LimeProgramming/USB-2-232-KBD/README.md

# USB-2-232-KBD
 Converts USB mice and USB keyboards to serial mice and XT-AT-PS/2 keyboards.
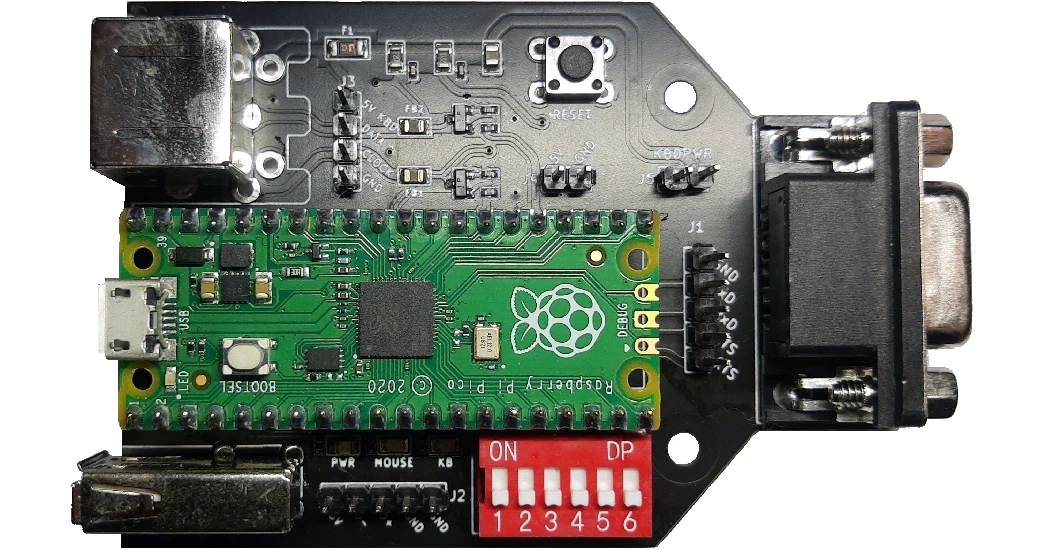
[picture p1: images/built.webp]
ASSEMBLED_ADAPTER
  

# Development
In progress, not ready for production

## About
This project is an extension of a previous project that you can find here  [previous project that you can find here.](https://github.com/LimeProgramming/USB-serial-mouse-adapter)
My previous project just converted USB mice to Serial mice, this project aims to also convert USB keyboards to XT-AT-PS/2 keyboards. 

# Features
### KVM:
Support for use on KVMs has been added as of version 1.1.1. 
It works fine on my **one**, startech branded, KVM that I have test with. Given that TinyUSB is a bit picky, your results may vary.

## Mouse Features
With this adapter you can convert a modern native USB mouse to a classic serial mouse. 
Want to use an optical mouse on a 386 running Wolfenstein 3D? Well now you can! Want to use a wireless optical mouse on a 486 running Doom? Well you might be able to! (depending on the mouse)

**Supported Protocols:**
- Microsoft Two Button
- Logitech Three Button
- Microsoft Wheel

## Hardware
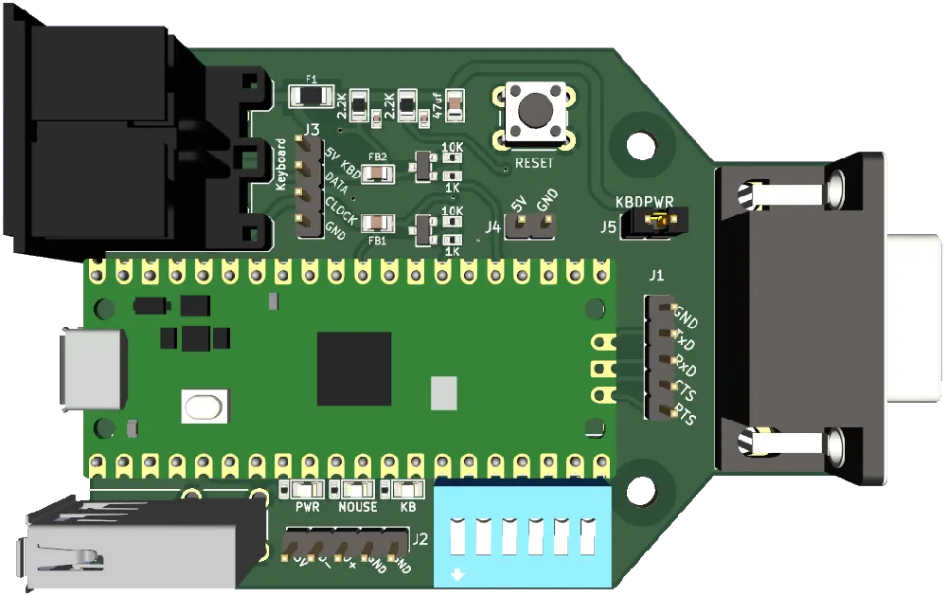
[picture p2: images/front_nobg.webp]
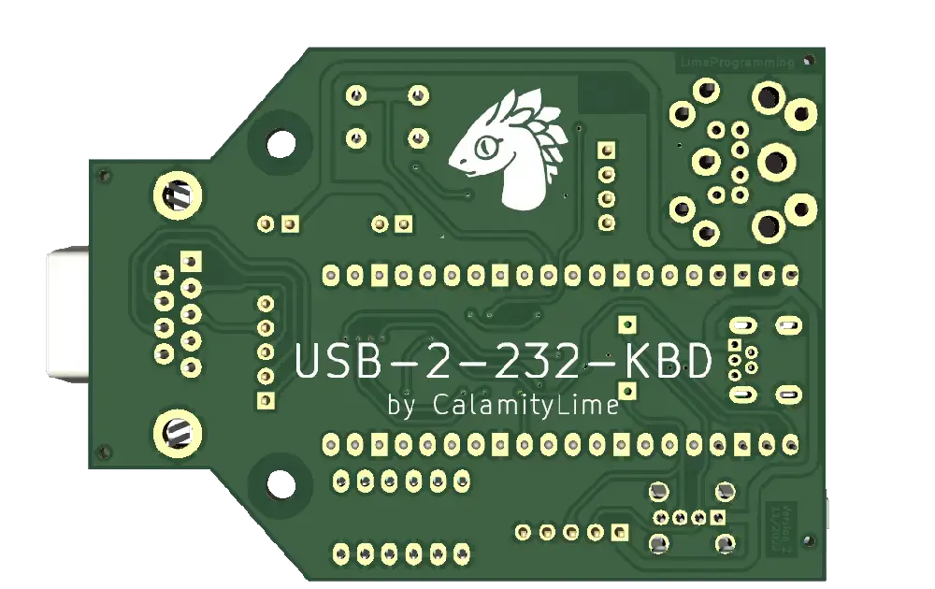
[picture p3: images/back_nobg.webp]
Back_PCB
[](https://raw.githubusercontent.com/LimeProgramming/USB-2-232-KBD/dev/images/front_bg.jpg)[](https://raw.githubusercontent.com/LimeProgramming/USB-2-232-KBD/dev/images/back_bg.jpg)

For the PCB I tried to mimic real keyboard hardware where possible. My old AT keyboard uses 2.2k pull-ups, ferrites, clamp caps and so this PCB does as well for the keyboard interface. Interfacing directly with the GPIO via level shifters uses much higher pullup values, no clamp caps to mitigate signal bounce, no ferrites to mitigate signal noise and importantly, no fuse on the power in line from the host PC. Technically, using a level shifters should work just fine but it is a bit out of spec so early AT and XT machines *may* have issues with level shifters.

I mentioned a fuse, there is a 750ma poly fuse on the PCB as standard. It seems that most AT motherboards have a 1 amp fuse for their keyboard, however that will need to be changed if it pops. While RGB keyboards and mice use more power than the old AT keyboards, there is still more than enough headroom for powering them. Issues can pop up if you're pulling too much power from the keyboard port or back feeding power into the motherboard. For example, my KVM will pull power from the USB port if it is not being powered by it's power adapter, it could potentially pull more than 1 amp, so hopefully the self resetting poly fuse will pop before the 1amp fuse on your motherboard. 

If you want to power the adapter from the keyboard port, put a jumper on pin header J5, label KBDPWR. 
**Important:** If you're powering the adapter using any other methods (eg, built in mini USB, picos micro usb, J4 pin header or a KVM) you must take the jumper off of J5. You risk back feeding a connected computer. 

### Din or PS/2 Port
The PCB can use either a din or a PS/2 port in the same footprint. You can choose which you want to use based on your use case. Recommended use case would be to use the PS/2 port because 6 pin mini din cables are cheap and easy to find.

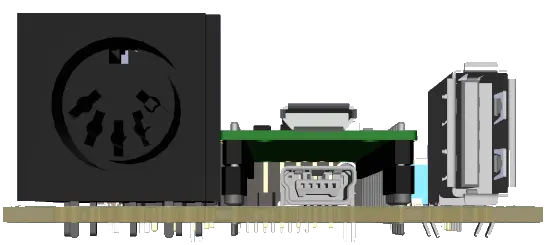
[picture p4: images/rear_nobg.webp]
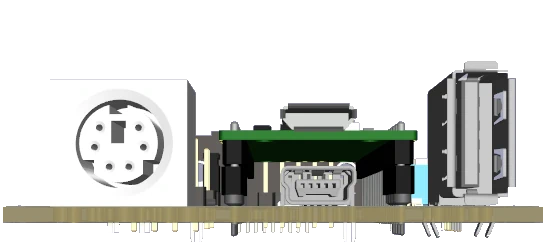
[picture p5: images/rear_ps2_nobg.webp]
[](https://raw.githubusercontent.com/LimeProgramming/USB-2-232-KBD/dev/images/rear_bg.jpg)[](https://raw.githubusercontent.com/LimeProgramming/USB-2-232-KBD/dev/images/rear_ps2_bg.jpg)

### Resetting the adapter
Forgot your settings and can't get the adapter working? Don't worry.
There are three different ways to reset the adapter:

#### --- Serial Terminal
As written above, you can reset the adapter back to default settings from the terminal. You can connect to the unused UART of the pico regardless of the settings of the mouse. 

#### --- Small Flat Head Screwdriver
[RESETTING_FLASH](https://raw.githubusercontent.com/LimeProgramming/USB-serial-mouse-adapter/main/images/reset_flash.jpg)

**How To:**
1. Press a small flat head into the position shown above.
2. Power on the adapter and the Picos built-in LED will glow solid.
3. Hold the flat head in position for two or three seconds for the Picos LED to start blinking.
4. Once it is blinking, you can let go of the GPIO and press the reset button.
5. The adapter will boot up with default settings.
#### --- Nuke UF2
**How To:**
1. Download the [flash_nuke.uf2](https://datasheets.raspberrypi.com/soft/flash_nuke.uf2) file.
2. Connect the adapter to your PC using the microusb port built into the Pi Pico.
3. Hold Reset, then bootsel, then release reset then bootsel. This will make the Pico appear as a removable storage device. 
4. Drag the flash_nuke.uf2 file to the storage device. This will reset the flash the on the Pi Pico.
5. The Pico should reboot on its own and show up as a removable storage device again. If it doesn't, tap the reset button.
6. Download the latest firmware and drag that UF2 file to the storage device.
7. The adapter will boot up with default settings.

# Compiling the Firmware
The default mouse settings can be edited in `default_config.h` prior to compilation. You can use this to set the default settings for your own configuration. 

The build environment is a normal PicoSDK setup, there are several guides out the for both Linux and Windows.  From experience the setup is easier in Linux. 

You'll need the following Libs:
 - [**PicoSDK Version: 1.4.0**](https://github.com/raspberrypi/pico-sdk)
 - [**TinyUSB Version: 0.14.0**](https://github.com/hathach/tinyusb)
 - [**TUSB Xinput**](https://github.com/Ryzee119/tusb_xinput)
