LimeProgramming/USB-2-232-KBD/images/back_bg.jpg

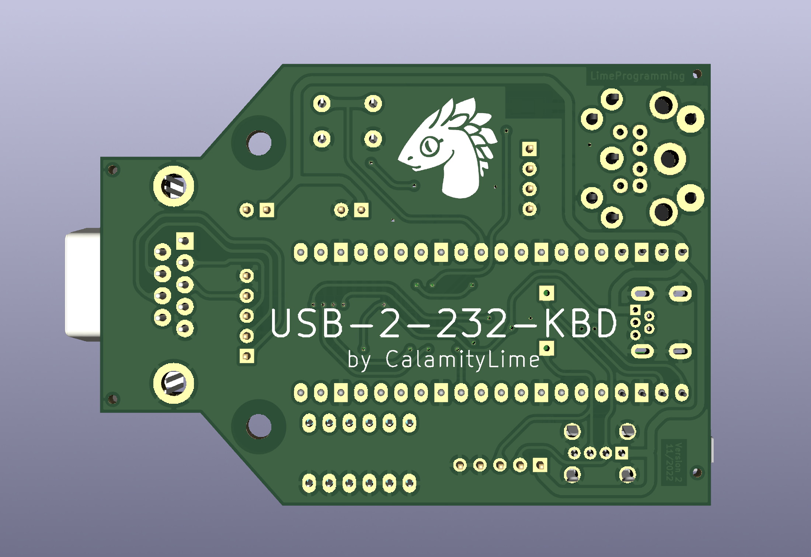
images/back_bg.jpg
