LimeProgramming/USB-2-232-KBD/images/built.jpg

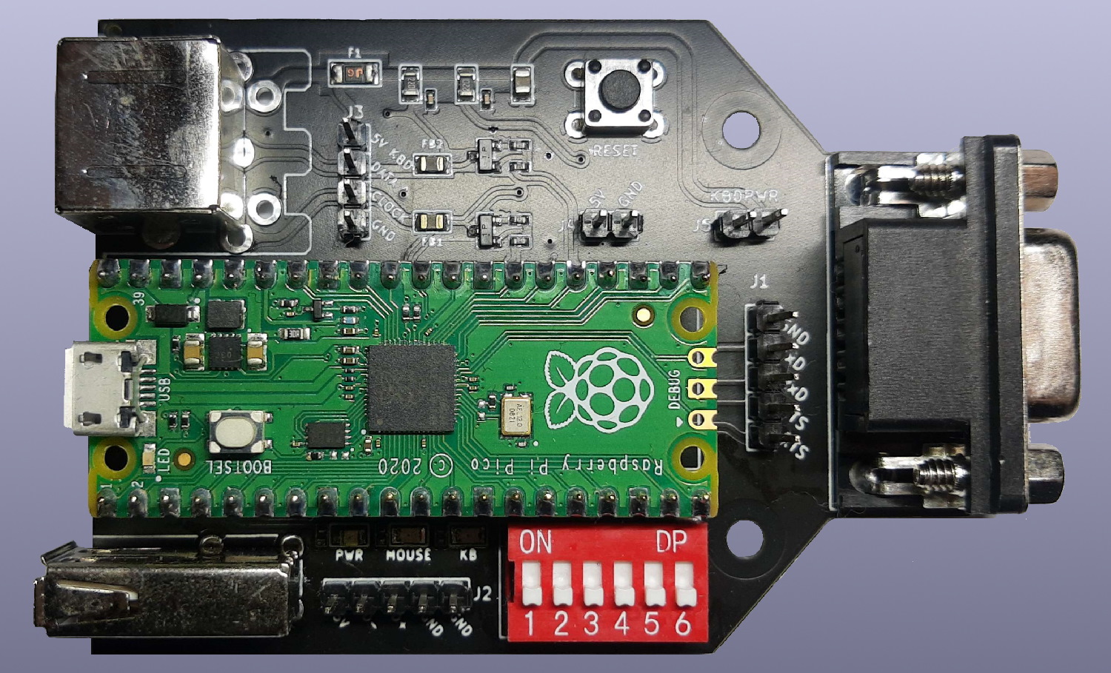
images/built.jpg
