LimeProgramming/USB-2-232-KBD/images/cosine smoothing chart.png

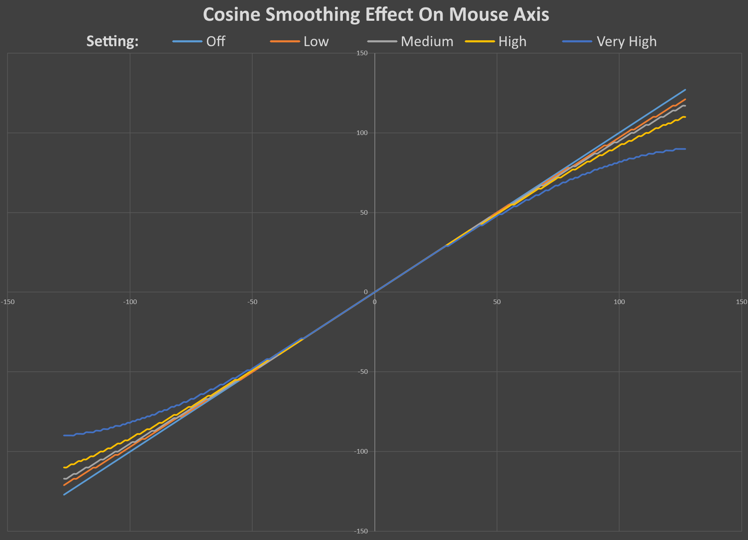
images/cosine smoothing chart.png
