LimeProgramming/USB-2-232-KBD/images/front_bg.jpg

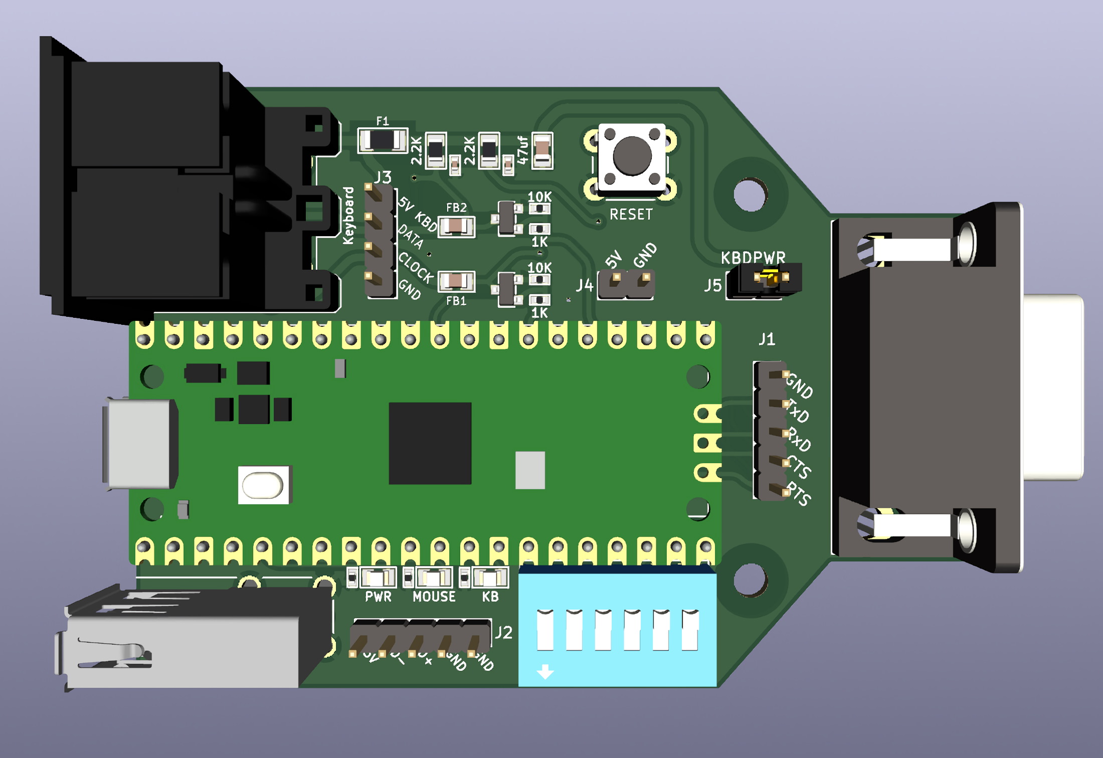
images/front_bg.jpg
