LimeProgramming/USB-2-232-KBD/images/Led Animation.gif

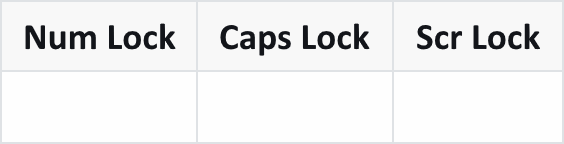
images/Led Animation.gif
