LimeProgramming/USB-2-232-KBD/images/rear_bg.jpg

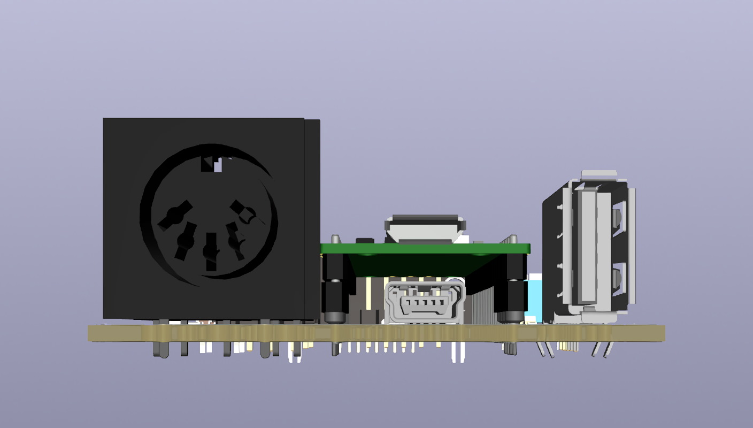
images/rear_bg.jpg
