LimeProgramming/USB-2-232-KBD/images/rear_ps2_bg.jpg

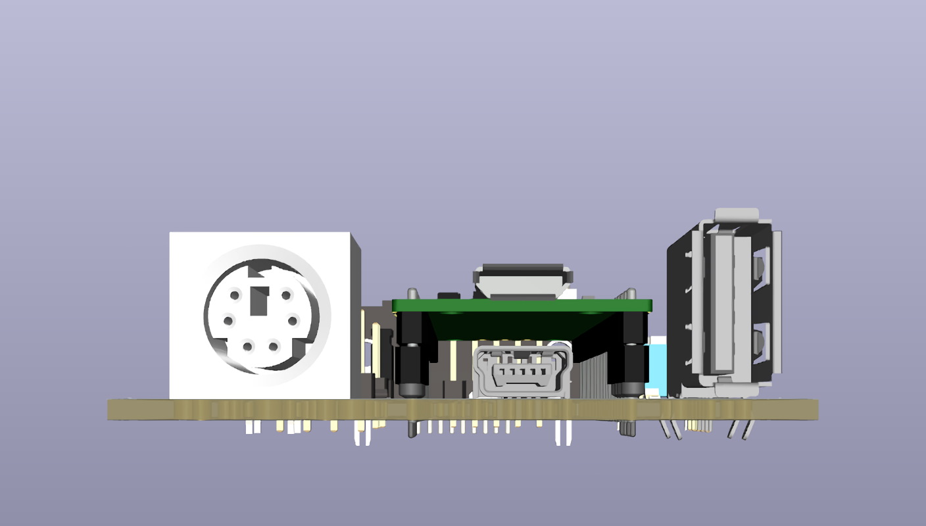
images/rear_ps2_bg.jpg
