LimeProgramming/USB-2-232-KBD/hw/Gerber/JLCPCB/USB-2-232-KBD-BOM.xls

Comment | Designator | Footprint | JLCPCB Part #（optional）
1uf | C2, C3, C4, C5, C6, C7 | 0402 | C52923
100nf | C9, C13 | 0402 | C1525
100uf | C1 | 1206 | C15008
47uf | C8 | 0805 | C16780
470pf | C10, C11 | 0402 | C1537
10uf | C12 | 1206 | C13585
LED_0805_KB | D1, D3 | 0805 | C2296
LED_0805_PWR | D2 | 0805 | C84256
Polyfuse | F1 | 1206 | C135339
Ferrite | FB1, FB2 | 0805 | C1015
npn | Q1, Q2 | SOT-23-3 | C8512
1K | R1, R2, R5, R6, R9 | 0402 | C11702
10K | R3, R4 | 0402 | C25744
2.2K | R7, R8 | 0402 | C17520
120K | R10 |  | C17436
Max232 | U1 | SOIC-16 | C26860
74LVC2G34 | U3, U4 | SOT-23-6 | C347589
CH340N | U5 |  | C2977777
