LimeProgramming/USB-2-232-KBD/DEBUGBUILD/readme.md

Folder includes a debug build of this firmware. It will print a information out though the serial usb mini port.

**For testing use only!**
