LimeProgramming/USB-2-232-KBD/hw/KiCad Project Files/USB-2-232-KBD.kicad_pcb

## KiCad design hw/KiCad Project Files/USB-2-232-KBD.kicad_pcb (2022-11-20)

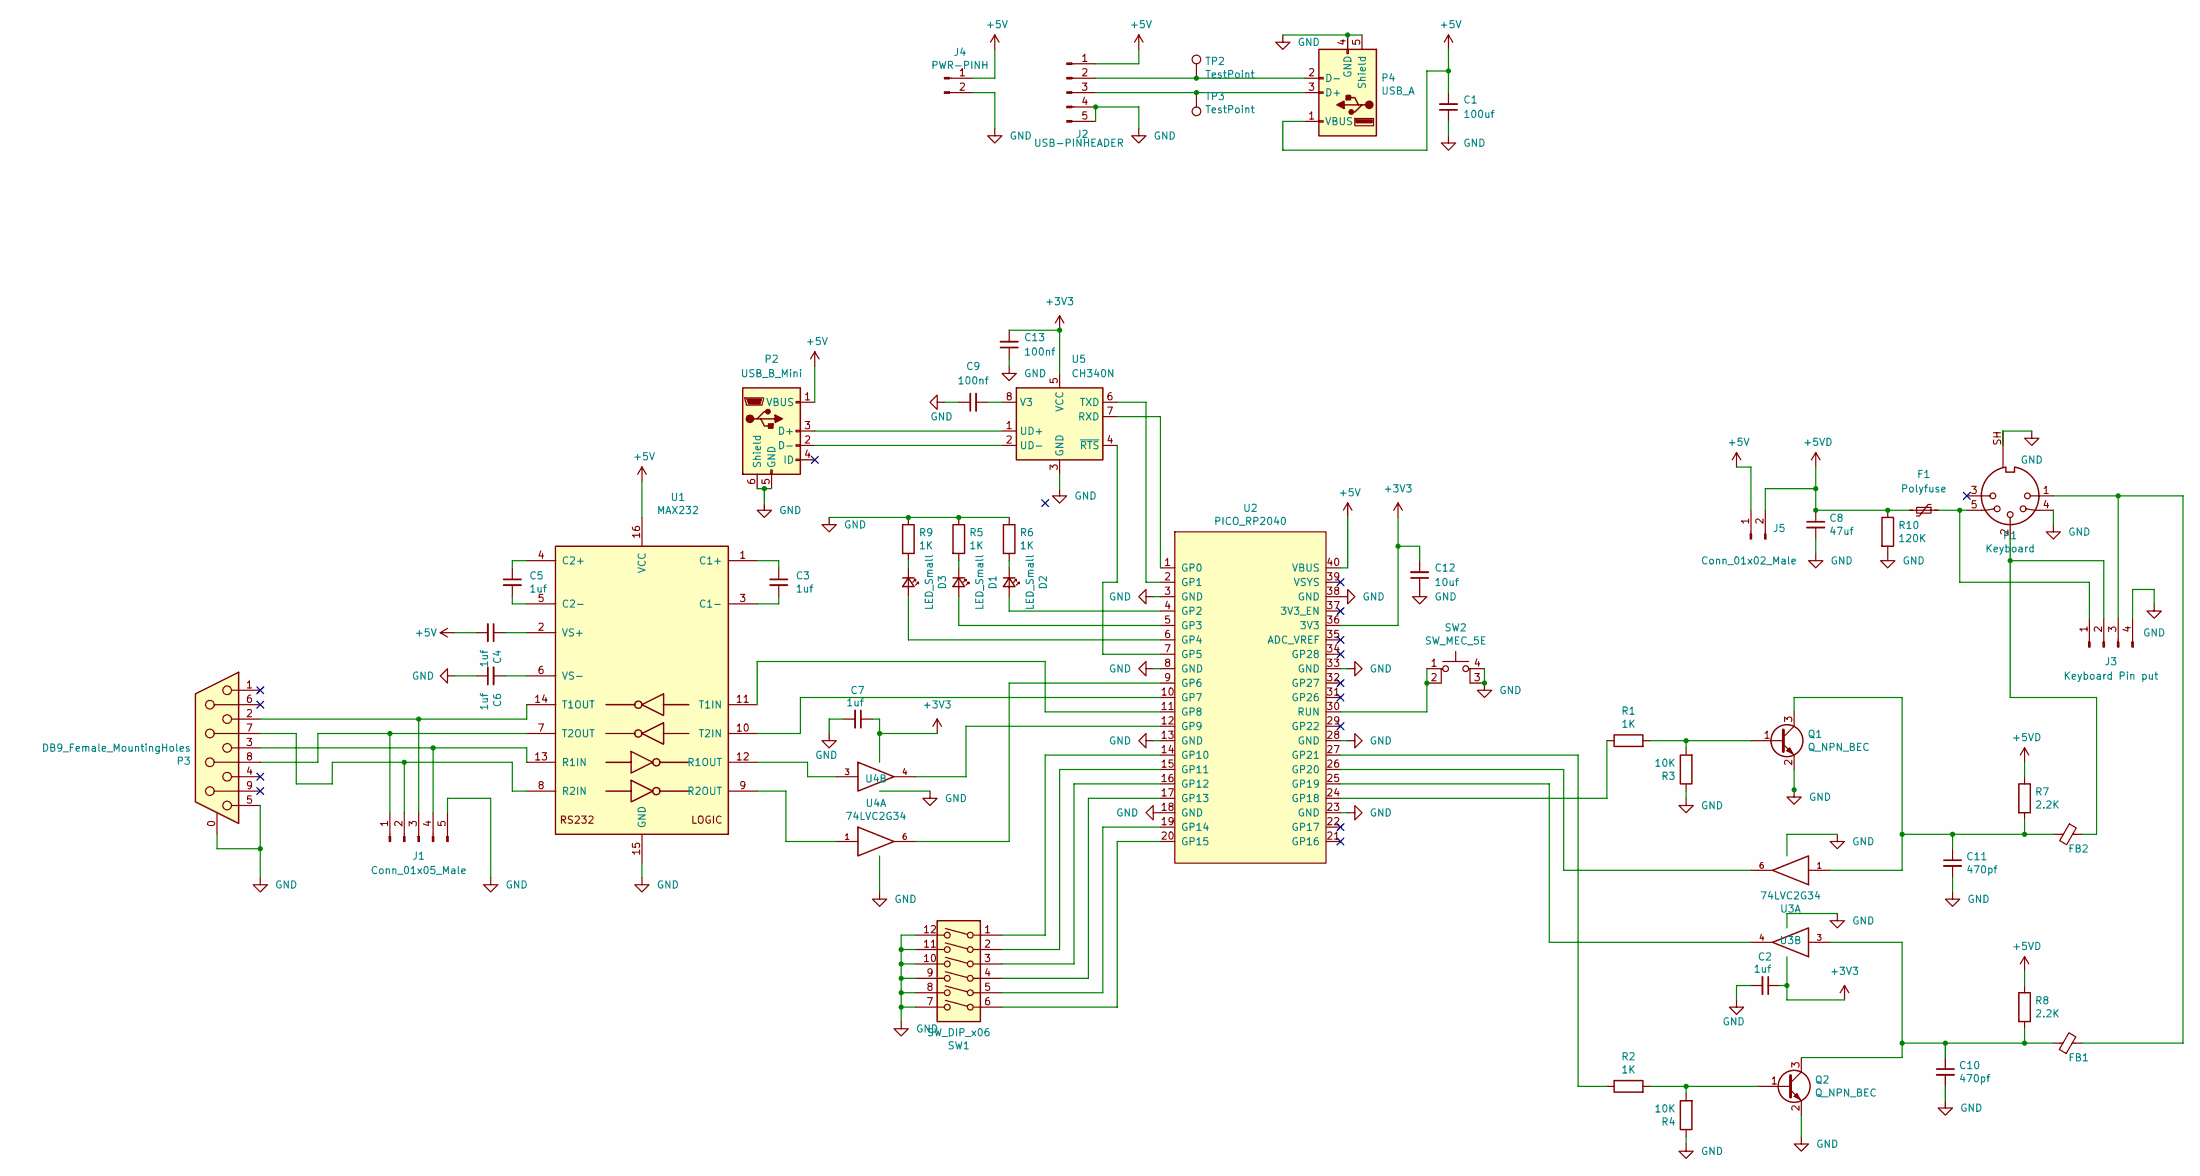
[picture p13: schematic USB-2-232-KBD.kicad_sch, USB-2-232-KBD - By: CalamityLime45]

Parts:
C1: 100uf; C_1206_3216Metric; JLC part C15008
C2, C4, C5, C7: 1uf; C_0402_1005Metric; JLC part C52923
C3, C6: 1uf; C_0402_1005Metric_ref-flip; JLC part C52923
C8: 47uf; C_0805_2012Metric; JLC part C16780
C9: 100nf; C_0402_1005Metric; JLC part C1525
C10: 470pf; C_0402_1005Metric
C11: 470pf; C_0402_1005Metric; JLC part C1537
C12: 10uf; C_1206_3216Metric; JLC part C13585
C13: 100nf; C_0402_1005Metric
D1: LED_Small; LED_0805_MOUSE; JLC part C2296
D2: LED_Small; LED_0805_PWR; JLC part C84256
D3: LED_Small; LED_0805_KB; JLC part C2296
F1: Polyfuse; PolyFuse_1206; JLC part C883129
FB1: Ferrite; FB_0805_2012Metric; JLC part C1015
FB2: Ferrite; FB_0805_2012Metric; JLC Part C1015
J1: Conn_01x05_Male; PinHeader_ALT_SERIAL_OUT_V2
J2: USB-PINHEADER; PinHeader_ALT_USB_IN
J3: Keyboard Pin put; AT_Keyboard_pin
J4: PWR-PINH; PinHeader_ALT_PWR_IN
J5: Conn_01x02_Male; PinHeader_PWR_FROM_AT
P1: Keyboard; DIN-PS2-COMBO
P2: USB_B_Mini; USB_Mini-B; JLC part C2977777
P3: DB9_Female_MountingHoles; DSUB-9_Female_Horizontal_P2.77x2.84mm_EdgePinOffset7.70mm_H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
P4: USB_A; USB_A_Wuerth_614004134726_Horizontal
Q1, Q2: Q_NPN_BEC; SOT-23-3; JLC part C8512
R1, R2, R5, R6, R9: 1K; R_0402_LEDS; JLC part C11702
R3, R4: 10K; R_0402_LEDS; JLC part C25744
R7, R8: 2.2K; R_0805_2012Metric; JLC part C17520
R10: 120K; R_0805_2012Metric; JLC Part C17436
SW1: SW_DIP_x06; SW_DIP_SPSTx06_Slide_9.78x17.42mm_W7.62mm_P2.54mm
SW2: SW_MEC_5E; SW_PUSH_6mm
TP2: TestPoint; TP2_Pad_TH_1.5x1.5
TP3: TestPoint; TP3_Pad_TH_1.5x1.5
U1: MAX232; max232_soic-16; JLC part C26860
U2: PICO_RP2040; RPi_Pico_SMD_THv2
U3, U4: 74LVC2G34; SOT-23-6; JLC part C347589
U5: CH340N; JLC part C2977777

Connections:
+3V3: C2.1, C7.1, C12.2, C13.2, U2.36 (3V3), U3.5, U4.5, U5.5 (VCC)
+5V: C1.2, C4.2, J2.1, J4.1, J5.1, P2.1 (VBUS), P4.1 (VBUS), U1.16 (VCC), U2.40 (VBUS)
+5VD: C8.1, F1.2, J5.2, R7.1, R8.1, R10.1
GND: C1.1, C2.2, C6.1, C7.2, C8.2, C9.1, C10.2, C11.2, C12.1, C13.1, J1.5, J2.4, J2.5, J3.4, J4.2, P1.4, P1.SH, P2.5 (GND), P2.6 (Shield), P3.0 (PAD), P3.5, P4.4 (GND), P4.5 (Shield), Q1.2 (E), Q2.2 (E), R3.1, R4.1, R5.1, R6.1, R9.1, R10.2, SW1.7, SW1.8, SW1.9, SW1.10, SW1.11, SW1.12, SW2.3 (K), SW2.4 (A), U1.15 (GND), U2.3 (GND), U2.8 (GND), U2.13 (GND), U2.18 (GND), U2.23 (GND), U2.28 (GND), U2.33 (GND), U2.38 (GND), U3.2, U4.2, U5.3 (GND)
unnamed: C3.1, U1.1 (C1+)
unnamed: C3.2, U1.3 (C1-)
unnamed: C4.1, U1.2 (VS+)
unnamed: C5.1, U1.4 (C2+)
unnamed: C5.2, U1.5 (C2-)
unnamed: C6.2, U1.6 (VS-)
unnamed: C9.2, U5.8 (V3)
unnamed: C10.1, FB1.1, Q2.3 (C), R8.2, U3.3
unnamed: C11.1, FB2.2, Q1.3 (C), R7.2, U3.1
unnamed: D1.1 (K), R5.2
unnamed: D1.2 (A), U2.5 (GP3)
unnamed: D2.1 (K), R6.2
unnamed: D2.2 (A), U2.4 (GP2)
unnamed: D3.1 (K), R9.2
unnamed: D3.2 (A), U2.6 (GP4)
unnamed: F1.1, J3.1, P1.5
unnamed: FB1.2, J3.3, P1.1
unnamed: FB2.1, J3.2, P1.2
unnamed: J1.1, P3.8, U1.7 (T2OUT)
unnamed: J1.2, P3.7, U1.8 (R2IN)
unnamed: J1.3, P3.2, U1.14 (T1OUT)
unnamed: J1.4, P3.3, U1.13 (R1IN)
unnamed: J2.2, P4.2 (D-), TP2.1
unnamed: J2.3, P4.3 (D+), TP3.1
unnamed: P2.2 (D-), U5.2 (UD-)
unnamed: P2.3 (D+), U5.1 (UD+)
unnamed: Q1.1 (B), R1.2, R3.2
unnamed: Q2.1 (B), R2.2, R4.2
unnamed: R1.1, U2.24 (GP18)
unnamed: R2.1, U2.27 (GP21)
unnamed: SW1.1, U2.14 (GP10)
unnamed: SW1.2, U2.15 (GP11)
unnamed: SW1.3, U2.16 (GP12)
unnamed: SW1.4, U2.17 (GP13)
unnamed: SW1.5, U2.19 (GP14)
unnamed: SW1.6, U2.20 (GP15)
unnamed: SW2.1, SW2.2, U2.30 (RUN)
unnamed: U1.9 (R2OUT), U4.1
unnamed: U1.10 (T2IN), U2.10 (GP7)
unnamed: U1.11 (T1IN), U2.11 (GP8)
unnamed: U1.12 (R1OUT), U4.3
unnamed: U2.1 (GP0), U5.7 (RXD)
unnamed: U2.2 (GP1), U5.6 (TXD)
unnamed: U2.7 (GP5), U5.4 (~RTS)
unnamed: U2.9 (GP6), U4.6
unnamed: U2.12 (GP9), U4.4
unnamed: U2.25 (GP19), U3.4
unnamed: U2.26 (GP20), U3.6

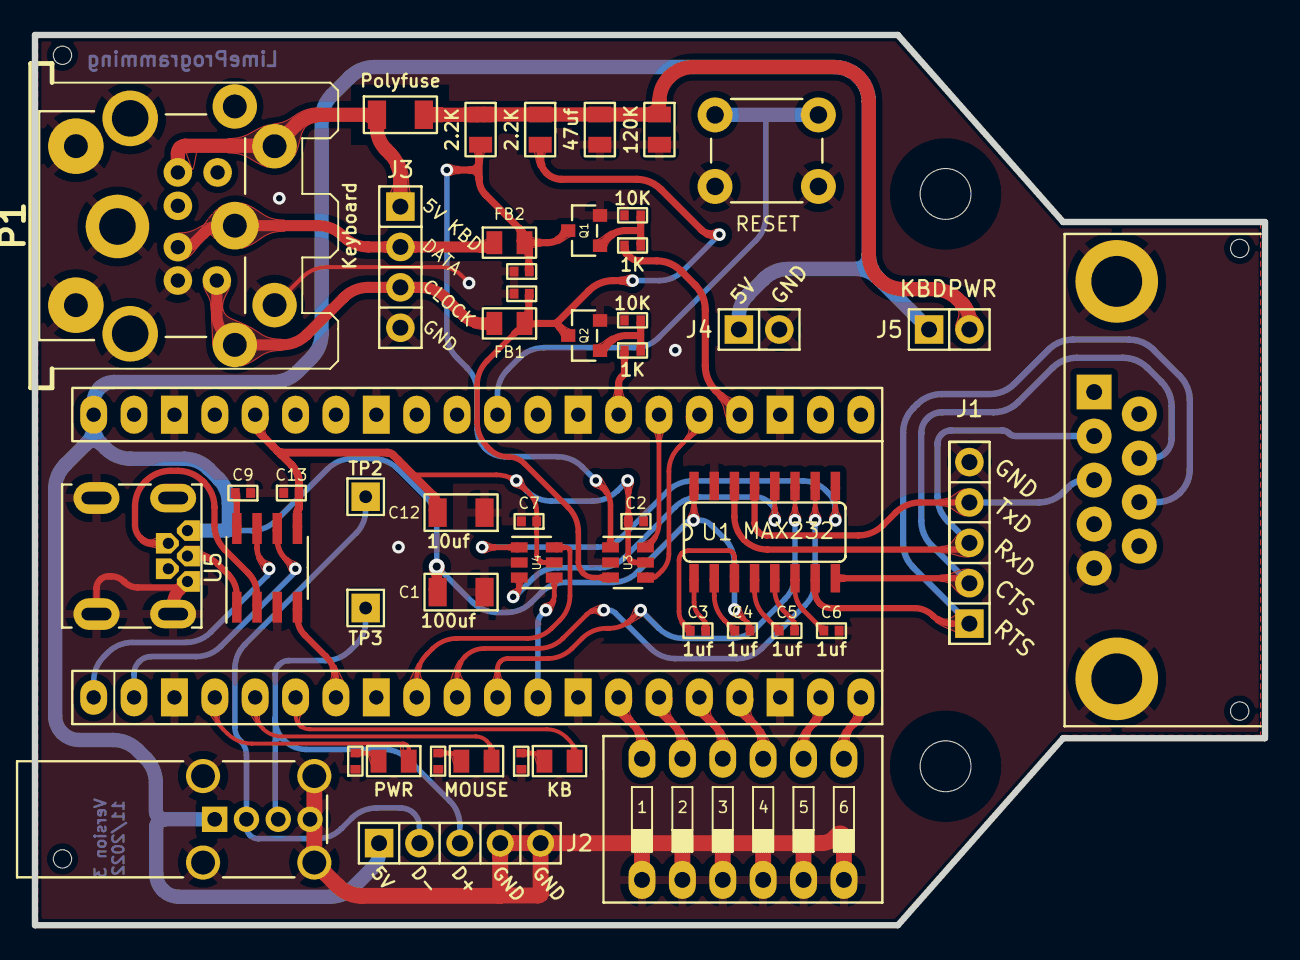
[picture p14: board USB-2-232-KBD.kicad_pcb from above]

Board: 2 copper layers, 77.4 x 56.0 mm, 49 parts (0 on the bottom side), 52 nets.
