LimeProgramming/USB-2-232-KBD/fimware/tusb_config.h

#ifndef _TUSB_CONFIG_H_
#define _TUSB_CONFIG_H_

#ifdef __cplusplus
 extern "C" {
#endif

//--------------------------------------------------------------------+
// Board Specific Configuration
//--------------------------------------------------------------------+

// RHPort number used for host can be defined by board.mk, default to port 0
#ifndef BOARD_TUH_RHPORT
#define BOARD_TUH_RHPORT      0
#endif

// RHPort max operational speed can defined by board.mk
#ifndef BOARD_TUH_MAX_SPEED
#define BOARD_TUH_MAX_SPEED   OPT_MODE_DEFAULT_SPEED
#endif

//--------------------------------------------------------------------
// COMMON CONFIGURATION
//--------------------------------------------------------------------

// defined by compiler flags for flexibility
#ifndef CFG_TUSB_MCU
  #error CFG_TUSB_MCU must be defined
#endif

#ifndef CFG_TUSB_DEBUG
#define CFG_TUSB_DEBUG              0
#endif

#define CFG_TUSB_MCU          OPT_MCU_RP2040
#define CFG_TUSB_RHPORT0_MODE OPT_MODE_HOST

#ifndef CFG_TUSB_OS
#define CFG_TUSB_OS                 OPT_OS_NONE
#endif


// Use pico-pio-usb as host controller for raspberry rp2040
//  #if CFG_TUSB_MCU == OPT_MCU_RP2040
//  #define CFG_TUH_RPI_PIO_USB   1
//  #endif

// CFG_TUSB_DEBUG is defined by compiler in DEBUG build
//#define CFG_TUSB_DEBUG           0

/* USB DMA on some MCUs can only access a specific SRAM region with restriction on alignment.
 * Tinyusb use follows macros to declare transferring memory so that they can be put
 * into those specific section.
 * e.g
 * - CFG_TUSB_MEM SECTION : __attribute__ (( section(".usb_ram") ))
 * - CFG_TUSB_MEM_ALIGN   : __attribute__ ((aligned(4)))
 */
#ifndef CFG_TUSB_MEM_SECTION
#define CFG_TUSB_MEM_SECTION
#endif

#ifndef CFG_TUSB_MEM_ALIGN
#define CFG_TUSB_MEM_ALIGN          __attribute__ ((aligned(4)))
#endif

//--------------------------------------------------------------------
// HOST CONFIGURATION
//--------------------------------------------------------------------

// Size of buffer to hold descriptors and other data used for enumeration
#define CFG_TUH_ENUMERATION_BUFSIZE 384

#define CFG_TUH_ENABLED             1 // TinyUSB host service
#define CFG_TUH_HUB                 2 // Number of Hubs chained
#define CFG_TUH_HID                 4 // Typical keyboard + mouse device can have 3 - 4 HID devices
#define CFG_TUH_CDC                 0 // Virtual Com I think
#define CFG_TUH_MSC                 0 // Mass Storage
#define CFG_TUH_VENDOR              0 // Just fucking broken
#define CFG_TUH_XINPUT              1 // How many XINPUT controllers you want to support


// Max number of devices connected
#define CFG_TUH_DEVICE_MAX          (CFG_TUH_HUB ? 4 : 1) // normal hub has 4 ports

//------------- HID -------------//
#define CFG_TUH_HID_EPIN_BUFSIZE    64
#define CFG_TUH_HID_EPOUT_BUFSIZE   64

#ifdef __cplusplus
 }
#endif

#endif /* _TUSB_CONFIG_H_ */
