LimeProgramming/USB-2-232-KBD/fimware/include/ps2dev.c

/*
Special thanks to:

PS2DEV GitHub: https://github.com/Harvie/ps2dev

This article by Adam Chipweske
https://www.tayloredge.com/reference/Interface/atkeyboard.pdf

*/

#include "hardware/gpio.h"

// Needed to account for update in tinyUSB
#if __has_include("bsp/board_api.h")
  #include "bsp/board_api.h"
#else
  #include "bsp/board.h"
#endif

#include "utils.h"
#include "ps2dev.h"
#include "din_lookups.h"
#include <default_config.h>

// ========== From PS2 dev ==========
//since for the device side we are going to be in charge of the clock,
//the two defines below are how long each _phase_ of the clock cycle is
#define CLKFULL 40
// we make changes in the middle of a phase, this how long from the
// start of phase to the when we drive the data line
#define CLKHALF 20
// Delay between bytes
// I've found i need at least 400us to get this working at all,
// but even more is needed for reliability, so I've put 1000us
#define BYTEWAIT 1000

// ========== XT variants of vars above ==========
#define XT_CLKSTART 120
#define XT_CLKINIT 50
#define XT_CLKFULL 66
#define XT_CLKHALF 30

// numbers from IBM model F
//#define XT_CLKSTART 107
//#define XT_CLKINIT 200
//#define XT_CLKFULL 61
//#define XT_CLKHALF 27

// Timeout if computer not sending for 30ms
#define TIMEOUT 30

static absolute_time_t BYTEWAIT_TIMESTAMP;


//--------------------------------------------------------------------+
//          Din port handling functions
//--------------------------------------------------------------------+

// Set the state of the data line of the din port
void setDATA(bool state) {
    // Because the data and clock lines are toggled low by turning on an NPN, it was a little obscure to put a 0 to set high.
    if ( state == 1 ) {
        gpio_put( PS2_DATA_OUT, 0 );
    } else {
        gpio_put( PS2_DATA_OUT, 1 );
    }

    return;
}

// Set the state of the clock line of the din port
void setCLOCK(bool state) {
    // Because the data and clock lines are toggled low by turning on an NPN, it was a little obscure to put a 0 to set high.
    if ( state == 1 ) {
        gpio_put( PS2_CLOCK_OUT, 0 );
    } else {
        gpio_put( PS2_CLOCK_OUT, 1 );
    }

    return;
}

// Is either Clock or data lines high
bool din_available() {
  return ( !gpio_get(PS2_DATA_IN) || !gpio_get(PS2_CLOCK_IN) );
}

// Din port isn't doing anything
bool din_idle() {
    return ( gpio_get(PS2_DATA_IN) && gpio_get(PS2_CLOCK_IN) );
}

// Are Clock and Data lines are low, it could mean that the pc is off
bool din_dead() {
    return ( !gpio_get(PS2_DATA_IN) && !gpio_get(PS2_CLOCK_IN) );
}

// Try initialing with the computers keyboard controller
bool din_init() {   
    
    // Attempt to connect 5 times before returning as a failure
    for ( uint8_t i = 0 ; i < 5 ; i++ ) {
        
        int8_t ret = at_write(0xAA);

         // If we can connect set ret to true
        if (  ret == 0 ) { 
            return true;           }

        busy_wait_ms(10);
    }
    return false;
}


//--------------------------------------------------------------------+
//          Functions for communicating with XT keyboard controllers
//--------------------------------------------------------------------+

// ---- XT KBC Writing ----
// Send data over din port using XT protocol
int8_t xt_write(unsigned char keycode)
{   
    // Do NO-OP Commands while waiting for our timestamp    
    while ( !time_reached(BYTEWAIT_TIMESTAMP) ) { tight_loop_contents(); }
    
    // Clock Line Fail
    if ( !gpio_get(PS2_CLOCK_IN) )                              { return DIN_RET_CFAIL; }
    // Data Line Fail
    if ( !gpio_get(PS2_DATA_IN) )                               { return DIN_RET_DFAIL; }

    // Get the computers attention
    setDATA(0);                 // Pull Data Low
    busy_wait_us(XT_CLKINIT);   // Wait a bit

    // Start bit TODO: one or two start bits, curr 2 start bits
    setCLOCK(0);                // Set Clock Low
    setDATA(1);                 // Set Data High
    busy_wait_us(XT_CLKFULL);   // Wait for two start bits
    
    setCLOCK(1);                // Pull Up the clock
    
    // Transmit 8 bits of data,
    for(uint8_t bitcount = 0 ; bitcount < 9 ; bitcount++ ) {

        if ( bitcount == 0 ) { 
            setDATA(1);                     // The first data bit is always one. 
        } else {
            setDATA( (keycode & 0x01) );    // Set State of our data line
            keycode = keycode >> 1;         // Bitwise op to move onto the "next" bit
        }

        busy_wait_us(XT_CLKFULL);       // Wait while the clock line is high
        setCLOCK(0);                    // Set Clock Low     
        busy_wait_us(XT_CLKHALF);       // Mimic slower clocking to help compatibility
        setCLOCK(1);                    // Set Clock High
    }

    // Set our timestamp for the next soonest time we'll send a keycode 
    BYTEWAIT_TIMESTAMP = delayed_by_us( get_absolute_time(), BYTEWAIT);

    return 0;
}

// ---- XT KBC Reading ----
int8_t xt_read(unsigned char * value) { //todo
    }

// ---- XT KBC Polling ----
// At some point, the XT host will pull the keyboard clock low for 20 mS or more.
// When this happens, we need to simulate a keyboard reset.
void xt_poll() {

    // If clock line is high, return
    if ( gpio_get(PS2_CLOCK_IN) ) { return; }

    // With out clock line low, we need to time how long it remains low.
    absolute_time_t clowtime = get_absolute_time();
    while ( !gpio_get(PS2_CLOCK_IN) ) { tight_loop_contents(); }

    // If Clock wasn't low for at least 10 ms, return
    if ( 10000 > absolute_time_diff_us( clowtime, get_absolute_time() ) ) { return; }

    // Post diagnostic byte
    xt_write(ATXT_OKAY);

    // to do;
    //UpdateLED();

    return;
}

// ---- XT Posting the pause key ----
// Pause keys lack a release code and instead have one long ar of codes. 
// More memory efficient to use a function instead of translation table
uint8_t xt_pause_press() {
    xt_write(0xE1);
    xt_write(0x1D);
    xt_write(0x45);
    xt_write(0xE1);
    xt_write(0x9D);
    xt_write(0xC5);
    return 0;
}


//--------------------------------------------------------------------+
//          Functions for communicating with AT/PS2 keyboard controllers
//--------------------------------------------------------------------+

// ---- AT KBC Writing ----
// Send data over din port using AT protocol
int8_t at_write(unsigned char keycode)
{
    // Do NO-OP Commands while waiting for our timestamp    
    while ( !time_reached(BYTEWAIT_TIMESTAMP) ) { tight_loop_contents(); }

    unsigned char parity = 1;
    
    // Clock and Data Line fail
    if ( !gpio_get(PS2_CLOCK_IN) && !gpio_get(PS2_DATA_IN) )    { printf("cd fail"); return DIN_RET_DCFAIL; }
    // Clock Line Fail
    if ( !gpio_get(PS2_CLOCK_IN) )                              { printf("clock fail"); DIN_RET_CFAIL; }
    // Data Line Fail
    if ( !gpio_get(PS2_DATA_IN) )                               { printf("data fail"); return DIN_RET_DFAIL; }

     
    for (uint8_t bitcount=0 ; bitcount <= 10 ; bitcount++) {
        switch (bitcount) {
            case 0:     // Start bit
                setDATA( 0 );
                break;
            case 9:     // Parity bit
                setDATA( parity );
                break;
            case 10:    // Stop bit
                setDATA ( 1 );
                break;
            default:    // Our Data bits
                setDATA( (keycode >> (bitcount-1)) & 0x01 );   // Set our data line

                parity ^= (keycode >> (bitcount-1)) & 0x01;    // Parity Tracker
                //keycode >>= 1;                 // "move" onto the next keycode bit
                break;
        }

        // Jiggle the clock
        busy_wait_us(CLKHALF);  // Wait a bit
        setCLOCK( 0 );          // device sends on falling clock
        busy_wait_us(CLKFULL);  // Wait a bit
        setCLOCK( 1 );          // Raise our clock
        busy_wait_us(CLKHALF);  // Wait a bit.

    }

    // Set our timestamp for the next soonest time we'll send a keycode 
    // I'm not sure why but when E0 is sent to ps/2 KBD controllers, the host pulls the clock low for a bit, so we extend the waittime for an E0
    if ( keycode == 0xE0 ){
        BYTEWAIT_TIMESTAMP = delayed_by_us( get_absolute_time(), (BYTEWAIT*2));
    } else {
        BYTEWAIT_TIMESTAMP = delayed_by_us( get_absolute_time(), (BYTEWAIT));
    };

    #if DEBUG > 0
        printf("Sent Din Data 0x%x\n", keycode);
        fflush(stdout);
    #endif

    return 0;
}

// ---- AT KBC Reading ----
// Read data from the host computers KBC using the AT protocol
int8_t at_read(unsigned char * value) {
    uint data = 0x00;
    uint bit = 0x01;
    uint8_t cal_parity = 1;
    uint8_t rec_parity = 0;
    absolute_time_t ps2_read_conn_timeout = delayed_by_ms( get_absolute_time(), TIMEOUT);

    // wait for data line to go low and clock line to go high (or timeout)
    while( gpio_get(PS2_DATA_IN) || !gpio_get(PS2_CLOCK_IN) ) { 
        if ( time_reached(ps2_read_conn_timeout) )  { return DIN_RET_TOUT; }
    }    

    for (uint8_t bitcount=0 ; bitcount < 10 ; bitcount++) {
        switch (bitcount) {
            case 0:     // Start bit
                break;
            case 9:     // Parity bit
                 rec_parity = gpio_get(PS2_DATA_IN);
                break;
            default:    // Data we're getting from the pc
                data        |= ( gpio_get(PS2_DATA_IN) ) ? bit : 0x00;  // Our data tracker 
                cal_parity  ^= (int) gpio_get(PS2_DATA_IN);             // Parity Tacker

                bit <<= 1;                                              // shift the bit
                break;
        }
    
        // Jiggle the clock line
        busy_wait_us(CLKHALF); /**/ setCLOCK( 0 ); /**/ busy_wait_us(CLKFULL);/**/ setCLOCK( 1 );/**/ busy_wait_us(CLKHALF);
    }

    // Stop bit
    busy_wait_us(CLKHALF);
    setDATA( 0 );
    setCLOCK( 0 );
    busy_wait_us(CLKFULL);
    setCLOCK( 1 );
    busy_wait_us(CLKHALF);
    setDATA( 1 );

    *value = data & 0x00FF;

    #if DEBUG > 0
        printf("Read Din Data: Received data 0x%x | Received parity %s | Calculated parity %s\n", 
            *value,
            (rec_parity ? "1" : "0"),
            (cal_parity ? "1" : "0")
        );
        fflush(stdout);
    #endif

    // If the parity doesn't match, return parity fail error
    if (rec_parity != cal_parity) { return DIN_RET_PRFAIL; }
    
    // return successful read
    return DIN_RET_SUCC;
}

// ---- AT Posting the pause key ----
// Pause keys lack a release code and instead have one long ar of codes. 
// More memory efficient to use a function instead of translation table
uint8_t at_pause_press() {
    at_write(0xe1);
    at_write(0x14);
    at_write(0x77);
    at_write(0xe1);
    at_write(0xf0);
    at_write(0x14);
    at_write(0xe0);
    at_write(0x77);
    return 0;
}



void ps2ack()
{
  while(at_write(0xFA));
  return;
}

int keyboard_reply(unsigned char cmd)
{
    unsigned char val;

    switch (cmd) {

    case CMD_RESET: //reset
        //== Causes keyboard to enter "Reset" mode
        ps2ack();

        kbd_data.cmd_set.kbd_enabled = true;    // Enable the keyboard
        kbd_data.cmd_set.key_mkbktm = 0x07;     // Set Default All Keys state
        kbd_data.cmd_set.tm_delay = 500;        // Set Default Typematic delay of 0.5 seconds
        kbd_data.cmd_set.tm_rate = 100;         // Set Default Typematic rate of 10.9cps
        kbd_data.cmd_set.tm_key = 0x00;         // Blank the Typematic key  

        //the while loop lets us wait for the host to be ready
        while(at_write(ATXT_OKAY)!=0);

        #if DEBUG > 0
        printf("AT Command Set: Reset\n");
        fflush(stdout);
        #endif 

        break;

    case CMD_RESEND:
        ps2ack();

        #if DEBUG > 0
        printf("AT Command Set: RESEND\n");
        fflush(stdout);
        #endif 

        break;

    case SET_KEY_TYPE_MAKE: //##== PS/2 Only
        //== Allows the host to specify a key that is to send only make codes.
        //== This key will not send break codes or typematic repeat. 
        //== This key is specified by its set 3 scan code.
        ps2ack();

        #if DEBUG > 0
        printf("AT Command Set: Set Key Type Make\n");
        fflush(stdout);
        #endif 

        break;

    case SET_KEY_TYPE_MAKE_BREAK: //##== PS/2 Only
        //==  Similar to "Set Key Type Make", but both make codes and break codes are enabled (typematic is disabled.)
        ps2ack();
        
        #if DEBUG > 0
        printf("AT Command Set: Set Key Type Make Break\n");
        fflush(stdout);
        #endif 

        break;
    
    case SET_KEY_TYPE_TYPEMATIC: //##== PS/2 Only
        //== Similar to previous two commands, except make and typematic is enabled; break codes are disabled.
        ps2ack();

        #if DEBUG > 0
        printf("AT Command Set: Set Key Type Typematic\n");
        fflush(stdout);
        #endif 

        break;

    case SET_ALL_KEYS_TYPEMATIC_MAKE_BREAK: //##== PS/2 Only
        //== Default setting. Make codes, break codes, and typematic repeat enabled for all keys (except "Print Screen" key)
        kbd_data.cmd_set.key_mkbktm = 0x07;
        ps2ack();

        #if DEBUG > 0
        printf("AT Command Set: Set all keys typematic make break\n");
        fflush(stdout);
        #endif 

        break;

    case SET_ALL_KEYS_MAKE: //##== PS/2 Only
        //== Causes only make codes to be sent; break codes and typematic repeat are disabled for all keys.
        kbd_data.cmd_set.key_mkbktm = 0x04;
        ps2ack();

        #if DEBUG > 0
        printf("AT Command Set: Set All Keys Make\n");
        fflush(stdout);
        #endif 

        break;

    case SET_ALL_KEYS_MAKE_BREAK: //##== PS/2 Only
        //== Similar to previous two commands, except only typematic repeat is disabled.
        kbd_data.cmd_set.key_mkbktm = 0x06;
        ps2ack();

        #if DEBUG > 0
        printf("AT Command Set: Set All Keys Make Break\n");
        fflush(stdout);
        #endif 

        break;

    case SET_ALL_KEYS_TYPEMATIC: //##== PS/2 Only
        //== Similar to previous three commands, except only break codes are disabled. Make codes and typematic repeat are enabled.
        kbd_data.cmd_set.key_mkbktm = 0x05;
        ps2ack();

        #if DEBUG > 0
        printf("AT Command Set: Set All Keys Typematic\n");
        fflush(stdout);
        #endif 

        break;

    case SET_DEFAULT: 
        //== Load default typematic rate/delay (10.9cps / 500ms), key types (all keys typematic/make/break), and scan code set (2).

        kbd_data.cmd_set.kbd_enabled = true;    // Enable the keyboard
        kbd_data.cmd_set.key_mkbktm = 0x07;     // Set Default All Keys state
        kbd_data.cmd_set.tm_delay = 500;        // Set Default Typematic delay of 0.5 seconds
        kbd_data.cmd_set.tm_rate = 100;         // Set Default Typematic rate of 10.9cps
        kbd_data.cmd_set.tm_key = 0x00;         // Blank the Typematic key  

        ps2ack();
        
        #if DEBUG > 0
        printf("AT Command Set: Det Default\n");
        fflush(stdout);
        #endif 

        break;

    case CMD_DISABLE: // Disable
        //== Keyboard stops scanning, loads default values (see "Set Default" command), and waits further instructions

        kbd_data.cmd_set.kbd_enabled = false;   // Disable the keyboard
        kbd_data.cmd_set.key_mkbktm = 0x07;     // Set Default All Keys state
        kbd_data.cmd_set.tm_delay = 500;        // Set Default Typematic delay of 0.5 seconds
        kbd_data.cmd_set.tm_rate = 100;         // Set Default Typematic rate of 10.9cps
        kbd_data.cmd_set.tm_key = 0x00;         // Blank the Typematic key  

        ps2ack();

        #if DEBUG > 0
        printf("AT Command Set: Disable & Reset\n");
        fflush(stdout);
        #endif 

        break;

    case CMD_ENBALE: // Enable
        //== Re-enables keyboard after disabled using previous command.

        kbd_data.cmd_set.kbd_enabled = true;    // Enable the keyboard
        ps2ack();

        #if DEBUG > 0
        printf("AT Command Set: Enable\n");
        fflush(stdout);
        #endif 

        break;

    case SET_TYPEMATIC_RATE_DELAY: //set typematic rate
        //== Host follows this command with one argument byte that defines the typematic rate and delay

        ps2ack();

        if ( at_read(&val) == 0 ) {
            kbd_data.cmd_set.tm_delay = LKP_TM_DELAY[ (val & 0x60) >> 5 ];  // Store the Typematic Delay 
            kbd_data.cmd_set.tm_rate = LKP_TM_RRATE[ val & 0x1F ];          // Store Default Typematic rate of 10.9cps
            ps2ack();
        } 
        
        #if DEBUG > 0
        printf("AT Command Set: Set Typematic Rate Delay: Typematic rate %d | typematic delay %d\n", kbd_data.cmd_set.tm_rate, kbd_data.cmd_set.tm_delay );
        fflush(stdout);
        #endif

        break;

    case CMD_READ_ID: //##== PS/2 Only
        //== The keyboard responds by sending a two-byte device ID of 0xAB, 0x83

        ps2ack();
        at_write(0xAB);
        at_write(0x83);
        
        #if DEBUG > 0
        printf("AT Command Set: Read ID\n");
        fflush(stdout);
        #endif

        break;

    case SET_SCAN_CODE_SET:  //##== PS/2 Only
        //== Host follows this command with one argument byte, that specifies which scan code set the keyboard should use. 
        //== This argument byte may be 0x01, 0x02, or 0x03 to select scan code set 1, 2, or 3, respectively. 
        //== You can get the current scan code set from the keyboard by sending this command with 0x00 as the argument byte.

        ps2ack();

        if ( at_read(&val) == 0 ) {
            
            switch (val) {
            case 0x00:  
                // Host is looking for the scan code set we are set to
                at_write( (kbd_data.cmd_set.scancode_set + 0x01) );
                break;
            
            // 0x01 = scan code set 1 | 0x02 = scan code set 2 | 0x03 = scan code set 3
            case 0x01: case 0x02: case 0x03:
                kbd_data.cmd_set.scancode_set = (val - 0x01);
                break;
            }
               
            ps2ack();
        }

        #if DEBUG > 0
        printf("AT command Set: Set Scan Code Set\n");
        fflush(stdout);
        #endif 

        break;

    case CMD_EHCO: //echo
        //== The keyboard responds with "Echo" (0xEE).
        at_write(0xEE);

        #if DEBUG > 0
        printf("AT Command Set: Echo\n");
        fflush(stdout);
        #endif

        break;

    case SET_RESET_LEDS: //set/reset LEDs
        //== The host follows this command with one argument byte, that specifies
        //== the state of the keyboard's Num Lock, Caps Lock, and Scroll Lock LEDs
        ps2ack();

        if(!at_read(&kbd_data.cmd_set.led_state)) ps2ack(); //do nothing with the rate

        #ifdef DEBUG
        printf("AT Command Set: Set/Reset LEDS: %x\n", kbd_data.cmd_set.led_state);
        fflush(stdout);
        #endif

        return 1;
        break;
    }
    return 0;
}

int8_t pool_din_kbd() {
    
    // If the din port is potentially dead
    if ( din_dead() ) { return DIN_RET_DISCONN; }

    // If the DIN port is currently busy or something.
    if ( !din_available() )  { return DIN_RET_UNAVAIL; }

    unsigned char c;                        // Char stores data received from computer for KBD
    int8_t readresult = at_read(&c);        // Store the return of the read command.

    if ( readresult == DIN_RET_SUCC ) { 
        return keyboard_reply(c); }

    return readresult;                      // return result from the rad function.
}


//--------------------------------------------------------------------+
//          Functions for communicating with AT/PS2 keyboard controllers
//--------------------------------------------------------------------+


// Keyboard button is pressed, takes usbhid keycode and coverts it ps2 keycode for writing to ps2 out
uint8_t keyboard_make( unsigned char usbhidcode ) {
    
    // ========== Din initialized ==========
    // Don't talk over the DIN port if we don't know we have a connection to a host PC
    // It might interrupt the initialization process
    if ( !kbd_data.din_present || !kbd_data.din_initalised ) {
        return(0);
    }

    // ========== Command Set ==========
    // IF the AT type keyboard has been disabled by the PS/2 command set 
    // We're putting this check here to keep at_write unaffected for sending ACKS
    if ( kbd_data.persistent.kbd_type == 1 && !kbd_data.cmd_set.kbd_enabled ) {
        return(0);
    };

    // ========== Unknown Code ==========
    // In case the usbhid code sent is unknown, just ignore it
    if ( ( usbhidcode > 0xA4 && usbhidcode < 0xE0 ) || ( usbhidcode > 0xE7 ) ) {
        return 0; //TMP
    };

    // Loop through out look up array
    for(uint8_t i = 0 ; i < 2 ; i++) {   
        
        // ========== Modifiers ==========
        // Modifier key scan codes are stored in a different lookup table.
        if ( usbhidcode >= 0xE0 ) { 

            // Keyboard type
            // XT keyboards are set 1 only and do not have a method to switch scan codes. 
            // So we hard code the set to set 1 when in xt keyboard mode
            switch (kbd_data.persistent.kbd_type) {

            case 0x00:  // XT
                if ( USB2PS2SMake[usbhidcode - 0xE0][0x00][i] ) { // If lookup scancode modifier is not zero
                    xt_write( USB2PS2SMake[usbhidcode - 0xE0][0x00][i] ); 
                };
                break;

            case 0x01: // AT
                if ( USB2PS2SMake[usbhidcode - 0xE0][kbd_data.cmd_set.scancode_set][i] ) {
                    at_write( USB2PS2SMake[usbhidcode - 0xE0][kbd_data.cmd_set.scancode_set][i] );
                }
                break;
            }

            continue;   // Next itter
        }
        
        // ========== Pause/Break ==========
        // Pause/Break key is quite a bit different between Set 1, Set 2 and Set 3.
        // So here is some special handling just for the Pause/Break key
        if ( usbhidcode == 0x48 ) {

            switch ( kbd_data.cmd_set.scancode_set ) {
                case 0x01: // XT Keyboard
                    return(xt_pause_press()); // The function sends all the scan codes so we can exit the loop
                    break;
                case 0x02: // AT Keyboard
                    return(at_pause_press());
                    break;
                case 0x03: // PS/2 Set 3
                    if ( USB2PS2Make[0x48][2][i] != 0x00 ) { at_write( USB2PS2Make[0x48][2][i] ); };
                    break;
            }

            continue;   // Next itter
        }

        // ========== Regular Keycodes ==========

        // Keyboard type
        // XT keyboards are set 1 only and do not have a method to switch scan codes. 
        // So we hard code the set to set 1 when in XT keyboard mode
        switch (kbd_data.persistent.kbd_type) {

        case 0x00:  // XT
            if ( USB2PS2Make[usbhidcode][0x00][i] > 0x00 ) { // If lookup scancode modifier is not zero
                xt_write( USB2PS2Make[usbhidcode][0x00][i] ); 
            }
            break;

        case 0x01: // AT
            if ( USB2PS2Make[usbhidcode][kbd_data.cmd_set.scancode_set][i] > 0x00 ) {
                at_write( USB2PS2Make[usbhidcode][kbd_data.cmd_set.scancode_set][i] );
            }
            break;
        } // End switch
        
    } // End for loop

    return 0;
}

// Keyboard buttons is depressed, takes usbhid keycode and converts it to ps2 keycode for writing to ps2 out
uint8_t keyboard_break( unsigned char usbhidcode ) {

    // ========== Din initialized ==========
    // Don't talk over the DIN port if we don't know we have a connection to a host PC
    // It might interrupt the initialization process
    if ( !kbd_data.din_present || !kbd_data.din_initalised ) {
        return(0);
    }

    // ========== Command Set ==========
    // IF the AT type keyboard has been disabled by the PS/2 command set 
    // We're putting this check here to keep at_write unaffected for sending ACKS
    if ( kbd_data.persistent.kbd_type == 1 && !kbd_data.cmd_set.kbd_enabled ) {
        return 0;
    };

    // ========== Unknown Code ==========
    // In case the usbhid code sent is unknown, just ignore it
    if ( ( usbhidcode > 0xA4 && usbhidcode < 0xE0 ) || ( usbhidcode > 0xE7 ) ) {
        return 0; //TMP
    }

    // Loop through out look up array
    for(uint8_t i = 0 ; i < 3 ; i++) {

        // ========== Modifier ==========
        // Modifier key scan codes are stored in a different lookup table.
        if ( usbhidcode >= 0xE0 ) {
      
            // Keyboard type
            // XT keyboards are set 1 only and do not have a method to switch scan codes. 
            // So we hard code the set to set 1 when in XT keyboard mode
            switch (kbd_data.persistent.kbd_type) {

            case 0x00:  // XT
                if ( USB2PS2SBreak[usbhidcode - 0xE0][0x00][i] ) { // If lookup scancode modifier is not zero
                    xt_write( USB2PS2SBreak[usbhidcode - 0xE0][0x00][i] ); 
                };
                break;

            case 0x01: // AT
                if ( USB2PS2SBreak[usbhidcode - 0xE0][kbd_data.cmd_set.scancode_set][i] ) {
                    at_write( USB2PS2SBreak[usbhidcode - 0xE0][kbd_data.cmd_set.scancode_set][i] );
                }
                break;
            }
            
            continue; // Next Itter 
        }
        
        // ========== Pause/Break ==========
        // Pause/Break key is quite a bit different between Set 1, Set 2 and Set 3.
        // So here is some special handling just for the Pause/Break key
        if ( usbhidcode == 0x48 ) {
            
            switch ( kbd_data.cmd_set.scancode_set ) {
                case 0x00: case 0x01: // Keyboard set 1 and 2 lack a pause/break release scan code set
                    return(0);
                    break;
                case 0x02: // PS/2 Set 3
                    if ( USB2PS2Break[0x48][2][i] != 0x00 ) { at_write( USB2PS2Break[0x48][2][i] ); };
                    break;
            }

            continue;   // Next itter
        }

        // ========== Regular Keycodes ==========
   
        // Keyboard type
        // XT keyboards are set 1 only and do not have a method to switch scan codes. 
        // So we hard code the set to set 1 when in XT keyboard mode
        switch (kbd_data.persistent.kbd_type) {

        case 0x00:  // XT
            if ( USB2PS2Break[usbhidcode][0x00][i] ) { // If lookup scancode modifier is not zero
                xt_write( USB2PS2Break[usbhidcode][0x00][i] ); 
            };
            break;

        case 0x01: // AT
            if ( USB2PS2Break[usbhidcode][kbd_data.cmd_set.scancode_set][i] ) {
                at_write( USB2PS2Break[usbhidcode][kbd_data.cmd_set.scancode_set][i] );
            }
            break;
        } // End Switch

    } // End for loop

    return 0;
}
