LimeProgramming/USB-2-232-KBD/fimware/include/din_lookups.h

#include "pico.h"

//these are really long and I wanted them out of the way

//--------------------------------------------------------------------+
//          Translation Tables
//--------------------------------------------------------------------+


// Look up table to convert USB keyboard keycodes to XT or AT keycodes.
// These values are for pressing the keys
// [KeyCode from TinyUSB][Set 1/Set 2/Set 3][PS2KEYCODES]
const uint8_t USB2PS2Make[][3][2] = {
    { {0x00,0x00}, {0x00,0x00}, {0x00,0x00} },  //HID_KEY_NONE
    { {0x00,0x00}, {0x00,0x00}, {0x00,0x00} },  //BLANK
    { {0x00,0x00}, {0x00,0x00}, {0x00,0x00} },  //BLANK
    { {0x00,0x00}, {0x00,0x00}, {0x00,0x00} },  //BLANK
    { {0x00,0x1E}, {0x00,0x1C}, {0x00,0x1C} },  //HID_KEY_A
    { {0x00,0x30}, {0x00,0x32}, {0x00,0x32} },  //HID_KEY_B
    { {0x00,0x2E}, {0x00,0x21}, {0x00,0x21} },  //HID_KEY_C
    { {0x00,0x20}, {0x00,0x23}, {0x00,0x23} },  //HID_KEY_D
    { {0x00,0x12}, {0x00,0x24}, {0x00,0x24} },  //HID_KEY_E
    { {0x00,0x21}, {0x00,0x2B}, {0x00,0x2B} },  //HID_KEY_F
    { {0x00,0x22}, {0x00,0x34}, {0x00,0x34} },  //HID_KEY_G
    { {0x00,0x23}, {0x00,0x33}, {0x00,0x33} },  //HID_KEY_H
    { {0x00,0x17}, {0x00,0x43}, {0x00,0x43} },  //HID_KEY_I
    { {0x00,0x24}, {0x00,0x3B}, {0x00,0x3B} },  //HID_KEY_J
    { {0x00,0x25}, {0x00,0x42}, {0x00,0x42} },  //HID_KEY_K
    { {0x00,0x26}, {0x00,0x4B}, {0x00,0x4B} },  //HID_KEY_L
    { {0x00,0x32}, {0x00,0x3A}, {0x00,0x3A} },  //HID_KEY_M
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
};

uint16_t const LKP_TM_DELAY[] = { 250, 500, 750, 1000 };

uint8_t const ATXT_OKAY =		0xAA;		// Scan code for "Diagnostics Passed"
uint8_t const AT_ACK =          0xFA;       // AT scan code for acknowledge


enum CommandSetCodes {
    CMD_RESET                               = 0xFF,     
    CMD_RESEND                              = 0xFE,     
    SET_KEY_TYPE_MAKE                       = 0xFD,     // PS2 ONLY
    SET_KEY_TYPE_MAKE_BREAK                 = 0xFC,     // PS2 ONLY
    SET_KEY_TYPE_TYPEMATIC                  = 0xFB,     // PS2 ONLY
    SET_ALL_KEYS_TYPEMATIC_MAKE_BREAK       = 0xFA,     // PS2 ONLY
    SET_ALL_KEYS_MAKE                       = 0xF9,     // PS2 ONLY
    SET_ALL_KEYS_MAKE_BREAK                 = 0xF8,     // PS2 ONLY
    SET_ALL_KEYS_TYPEMATIC                  = 0xF7,     // PS2 ONLY
    SET_DEFAULT                             = 0xF6,
    CMD_DISABLE                             = 0xF5,
    CMD_ENBALE                              = 0xF4,
    SET_TYPEMATIC_RATE_DELAY                = 0xF3,
    CMD_READ_ID                             = 0xF2,
    SET_SCAN_CODE_SET                       = 0xF0,     // PS2 ONLY
    CMD_EHCO                                = 0xEE,
    SET_RESET_LEDS                          = 0xED
};
