LimeProgramming/USB-2-232-KBD/fimware/include/utils.c

#include "tusb.h"
#include <math.h>
#include "pico/stdlib.h"
#include "hardware/sync.h"
#include "hardware/gpio.h"
#include "hardware/uart.h"
#include "hardware/flash.h"
#include "pico/binary_info.h"
#include "hardware/watchdog.h"

// Needed to account for update in tinyUSB
#if __has_include("bsp/board_api.h")
  #include "bsp/board_api.h"
#else
  #include "bsp/board.h"
#endif

#include "utils.h"
#include "core_1.h"
#include "serial.h"
#include "ps2dev.h"
#include "version.h"
#include <default_config.h>


// ==================================================================================================== //
//                                                UTILS                                                 //
// ==================================================================================================== //


int constraini(int16_t value, int16_t min, int16_t max) {
  if(value > max) { return max; }
  if(value < min) { return min; }
  return value;
}

uint8_t constrainui(uint8_t value, uint8_t min, uint8_t max) {
  if(value > max) { return max; }
  if(value < min) { return min; }
  return value;
}

// Configure GPIO for use as Pin Headers
void init_pinheader(uint pin)
{
  gpio_init(pin); 
  gpio_set_dir(pin, GPIO_IN);
  gpio_pull_up(pin);
}

// Configure GPIO to Power an LED
void init_led(uint pin)
{
  gpio_init(pin); 
  gpio_set_dir(pin, GPIO_OUT);
  gpio_put(pin, 0);
}

//I guess this will reboot the pico?
void machine_reboot()
{
  watchdog_reboot(0, SRAM_END, 0);
  for (;;) { __wfi(); }
  return;
}

// Blink the alert LED
void blink_aled(uint gpio, uint8_t code)
{
  bool pre_state = gpio_get(gpio);
  uint8_t errcodes[]= {1, 0, 1, 0, 1, 0, 1, 0, 1};

  gpio_put(gpio, 0);

  for ( uint8_t i = 0 ; i< sizeof(errcodes); i++ )
  {
    gpio_put(gpio, errcodes[i]);
    sleep_ms(100);
  }

  gpio_put(gpio, pre_state);
  
}


// ==================================================================================================== //
//                                          Repeating Timers                                            //
// ==================================================================================================== //


// Terminal checker timer
// --------------------------------------------------
//
// We're using a timer for the terminal since uart irq is buggy.
// Returning false from a repeating timer callback stops the timer. 

struct repeating_timer terminal_timer;

bool terminal_timer_callback(struct repeating_timer *t) {

  // Just a bit of safety
  if ( mouse_data.serial_state != 0 ) { return false; }   // Stop the timer

  // ----- Variables
  // Buffer for inputs from serial port (needs to be an array)
  uint8_t uart_data[2] = {0};                      

  // ----- Check UART0
  if( term_getc(uart0, uart_data, 2) > 0) {
      if( uart_data[0] == '\r'|| uart_data[0] == '\n' ) {
          mouse_data.serial_state = 1;                    // Set our Flag
          return false;                                   // Stop the timer
      }
  }
  
  // ----- Nuke UART DATA
  memset(uart_data, 0, 2);           
  
  // ----- Check UART1
  if( term_getc(uart1, uart_data, 2) > 0) {  
    printf("%d | %d\n", uart_data[0], uart_data[1]);
    fflush(stdout);

      if( uart_data[0] == '\r' || uart_data[0] == '\n' ) {
          mouse_data.serial_state = 2;                    // Set our Flag
          return false;                                   // Stop the timer
      }
  }

  return true;                                            // Keep running the timer
}

// Create 0.5 second timer for checking for terminal input
void startTerminalTimer() {                               
  add_repeating_timer_us(500000, terminal_timer_callback, NULL, &terminal_timer);
  return;
}

// Stop Our terminal timer
void stopTerminalTimer() {                                
  cancel_repeating_timer(&terminal_timer);    
  return;
}

// Terminal PWR LED Blinker
// --------------------------------------------------
//
// Timer to blink the PWR led to tell the user that the adapter is in serial terminal mode

struct repeating_timer PWR_blinker_timer;

bool PWR_blinker_timer_callback(struct repeating_timer *t) {
  // if PWR LED is on 
  if ( gpio_get(LED_PWR) ) {
    gpio_put(LED_PWR, 0);
  
  // Else it is off
  } else {
    gpio_put(LED_PWR, 1);
  }

  return true;
  
}

void startPWRBlinkerTimer() {                               
  add_repeating_timer_us(800000, PWR_blinker_timer_callback, NULL, &PWR_blinker_timer);
  return;
}

// Stop Our PWR LED blinker timer
void stopPWRBlinkerTimer() {                                
  cancel_repeating_timer(&PWR_blinker_timer);    
  return;
}


// ==================================================================================================== //
//                                         Mouse Settings Stuff                                         //
// ==================================================================================================== //


void calcSerialDelay(){

  //200 baud = 50.000 ms @ 8n1 

  // Works for bits per microsecond
  mouse_data.serialdelay_1b = ( 50000 / ( mouse_data.realbaudrate / 200.0 ) ) / 9;

  float tmp = 0.0;

  // Work out the time for 1, 3, 4 mouse packet(s)
  tmp = (mouse_data.serialdelay_1b * (mouse_data.persistent.doublestopbit ? 9 : 8) ) + TXWIGGLEROOM;
  tmp = ceilf(tmp);
  mouse_data.serialdelay_1B = (uint) tmp;
  mouse_data.serialdelay_3B =  mouse_data.serialdelay_1B * 3;
  mouse_data.serialdelay_4B =  mouse_data.serialdelay_1B * 4;

  #if DEBUG > 0
  printf("1 Bit: %4.2f | 1 Byte: %d | 3 Byte: %d | 4 Byte: %d\n" , mouse_data.serialdelay_1b, mouse_data.serialdelay_1B, mouse_data.serialdelay_3B, mouse_data.serialdelay_4B);
  #endif

  return;
}

// Set Serial Baud rate from the headers
void setDipSerialBaud() {
  if ( !gpio_get(DIPSW_19200) )  { mouse_data.persistent.baudrate = 19200; }
  else                           { mouse_data.persistent.baudrate = 1200; }

  return;
}

// Sets Mouse Speed from the headers.
void setDipMouseType() {   
  if      ( !gpio_get(DIPSW_WHEEL) )     { mouse_data.persistent.mousetype = WHEELBTN; }
  else if ( !gpio_get(DIPSW_THREEBTN) )  { mouse_data.persistent.mousetype = THREEBTN; }
  else                                   { mouse_data.persistent.mousetype = TWOBTN; }

  return;
}

// Updates Mouse Travel Rate Divider from the headers.
void setDipMouseSpeed()
{   
  if      ( !gpio_get(DIPSW_75XYSPEED) && !gpio_get(DIPSW_50XYSPEED) )    { mouse_data.persistent.xytravel_percentage = 25; }
  else if ( !gpio_get(DIPSW_50XYSPEED) )                                  { mouse_data.persistent.xytravel_percentage = 50; }
  else if ( !gpio_get(DIPSW_75XYSPEED) )                                  { mouse_data.persistent.xytravel_percentage = 75; }
  else                                                                    { mouse_data.persistent.xytravel_percentage = 100; }

  return;
}



// ==================================================================================================== //
//                                          Dip Switch IRQ                                              //
// ==================================================================================================== //


/*
I spent a bit of time trying to figure out the simplest way to have mouse settings update-able without restarting the pi pico.
I could have just called the above functions in the main loop all the time but that felt wasteful.
De-bounce in a gpio_callback doesn't work well, give it a Google, some fellow tried it and it was spotty.
I implemented a hardware de-bounce but decided against it, since it made the final PCB bigger for something not integral. 

Ultimately I decided it was best to add an alarm from a GPIO callback to act as a poor mans de-bounce.
*/

volatile bool DIPSW_MOUSE_IRQ = false;
volatile bool DIPSW_XYSPEED_IRQ = false;
volatile bool DIPSW_7N2_IRQ = false;
volatile bool DIPSW_19200_IRQ = false;

int64_t mouse_type_callback(alarm_id_t id, void *user_data) {  

  #if DEBUG > 0 
    printf("Mouse Type Callback called\n"); 
  #endif

  // Exit if the mouse is acting as a terminal
  if ( mouse_data.serial_state != 0 ) { return 0; }

  mouse_data.serial_state = 3;          // Stop the serial mouse timer 
  stop_core1();                         // Stop Core 1
  setDipMouseType();                    // Set Mouse Type from headers
  updateStoredDipswitchs();             // Get Dip Switch state
  savePersistentSet();                  // Save Updated Settings
  calcSerialDelay();                    // Update Serial Timings
  DIPSW_MOUSE_IRQ = false;              // Flag that we are done with this func
  mouse_data.serial_state = 0;          // Start the serial mouse timer 
  start_core1(0);                       // Start Core 1
  
  return 0;                                   
}

int64_t mouse_speed_callback(alarm_id_t id, void *user_data) {   

  #if DEBUG > 0 
    printf("Mouse Speed Callback called\n"); 
  #endif
  
    // Exit if the mouse is acting as a terminal
  if ( mouse_data.serial_state != 0 ) { return 0; }

  mouse_data.serial_state = 3;          // Stop the serial mouse timer 
  stop_core1();                         // Stop Core 1
  setDipMouseSpeed();                   // Get mouse speed from the headers
  updateStoredDipswitchs();             // Get Dip Switch state
  savePersistentSet();                  // Save persistent settings       
  DIPSW_XYSPEED_IRQ = false;            // Flag that we are done with this func
  mouse_data.serial_state = 0;          // Start the serial mouse timer 
  start_core1(0);                       // Start Core 1

  return 0;                                   
}

int64_t serial_format_callback(alarm_id_t id, void *user_data) {   

  #if DEBUG > 0 
    printf("Serial Format Callback called\n");
  #endif

  // Exit if the mouse is acting as a terminal
  if ( mouse_data.serial_state != 0 ) { return 0; }

  mouse_data.serial_state = 3;          // Stop the serial mouse timer 
  stop_core1();                         // Stop Core 1
  mouse_data.persistent.doublestopbit = !gpio_get(DIPSW_7N2);     // get the header state
  refresh_serial_uart();                // Refresh the uart with updated settings
  calcSerialDelay();
  updateStoredDipswitchs();             // Store header state
  savePersistentSet();                  // save persistent
  DIPSW_7N2_IRQ = false;                // Flag that the func is done
  mouse_data.serial_state = 0;          // Start the serial mouse timer 
  start_core1(0);                       // Start Core 1
  
  return 0;                                   
}

int64_t serial_speed_callback(alarm_id_t id, void *user_data) {  

  #if DEBUG > 0 
    printf("Serial Speed Callback called\n");
  #endif

  // Exit if the mouse is acting as a terminal
  if ( mouse_data.serial_state != 0 ) { return 0; }

  mouse_data.serial_state = 3;          // Stop the serial mouse timer 
  stop_core1();                         // Stop Core 1
  setDipSerialBaud();                   // Set new Baud rate based on dip switches
  refresh_serial_uart();                // Reinit serial with updated settings
  calcSerialDelay();                    // Recalculate serial delay used by the main mouse timer
  updateStoredDipswitchs();             // Poll all dip switches for state
  savePersistentSet();                  // Store all settings
  mouse_data.serial_state = 0;          // Start the serial mouse timer 
  DIPSW_19200_IRQ = false;              // Flag that this func is finished
  start_core1(0);                       // Start Core 1

  return 0;                                   
}

// Basically this is acting as a poor mans de-bounce on the dip switches
void dipswGPIOCallback(uint gpio, uint32_t events) {
  gpio_acknowledge_irq(gpio, events);         // ACK GPIO IRQ

  switch ( gpio ) {

    case DIPSW_THREEBTN: case DIPSW_WHEEL:

      if ( DIPSW_MOUSE_IRQ ) { break; }
      
      DIPSW_MOUSE_IRQ = true;
      add_alarm_in_ms(1500, mouse_type_callback, NULL, true);

    break;
    case DIPSW_75XYSPEED: case DIPSW_50XYSPEED: // 50% speed | 75% speed  | Dip 3 + 4 depressed will set mouse speed to 25%

      if ( DIPSW_XYSPEED_IRQ ) { break; }

      DIPSW_XYSPEED_IRQ = true; 
      add_alarm_in_ms(1500, mouse_speed_callback, NULL, true); 

    break;
    case DIPSW_7N2:

      if ( DIPSW_7N2_IRQ ) { break; }

      DIPSW_7N2_IRQ = true;
      add_alarm_in_ms(1500, serial_format_callback, NULL, true);

    break;
    case DIPSW_19200:
      
      if ( DIPSW_19200_IRQ ) { break; }

      DIPSW_19200_IRQ = true;
      add_alarm_in_ms(1500, serial_speed_callback, NULL, true); 

    break;
  }
}


// ==================================================================================================== //
//                                         Persistent Settings                                          //
// ==================================================================================================== //


#define FLASH_TARGET_OFFSET (384 * 1024)
#define FLASH_SECTOR_SIZE_C (1u << 16) // <-- Custom Sector Size

// Loads the default settings from default_config.h
void loadPersistentDefaults() {
  #if KB_ENALBE
  loadPersistentKBDDefaults();    // Load the keyboard default settings from default_config.h
  #endif

  loadPersistentMOUSEDefaults();  // Load the default settings from default_config.h

  return;
}

// Load persistent mouse data from flash | Load defaults if no data in flash found
// There's a pile of if's to try to combat silly users.
void loadPersistentMOUSEDefaults() {
  mouse_data.persistent.firstrun = 0;
  
  // Assume good because I set them.
  mouse_data.persistent.FW_V_MAJOR = V_MAJOR;
  mouse_data.persistent.FW_V_MINOR = V_MINOR;
  mouse_data.persistent.FW_V_REVISION = V_REVISION;

  // Simple Constrains
  mouse_data.persistent.xytravel_percentage =  constrainui(default_xytravel_percentage, 1, 200); //int8_t min, int8_t max) 
  mouse_data.persistent.xtravel_percentage =   constrainui(default_xtravel_percentage,  1, 200);
  mouse_data.persistent.ytravel_percentage =   constrainui(default_ytravel_percentage,  1, 200);

  // DipSwitches 
  // 1 = open | 0 = closed
  mouse_data.persistent.ST_DIPSW_THREEBTN = 1;
  mouse_data.persistent.ST_DIPSW_WHEEL = 1;
  mouse_data.persistent.ST_DIPSW_75XYSPEED = 1;
  mouse_data.persistent.ST_DIPSW_50XYSPEED = 1;
  mouse_data.persistent.ST_DIPSW_7N2 = 1;
  mouse_data.persistent.ST_DIPSW_19200 = 1;

  // Added version 1.1.X
  mouse_data.persistent.mouse_movt_type = default_mouse_movt_type;
  mouse_data.persistent.use_cosine_smoothing = default_use_cosine_smoothing;

  // Mouse type range
  switch ( default_mousetype )
  {
  case 0: case 1: case 2:
    mouse_data.persistent.mousetype = default_mousetype;
    break;

  default:
    mouse_data.persistent.mousetype = 0;
  }

  // Baud Rate range 
  switch ( default_baudrate ) 
  {
    case 1200: case 2400: case 4800: case 9600: case 19200:
      mouse_data.persistent.baudrate =      default_baudrate;
      break;
    default:
      mouse_data.persistent.baudrate =      1200;
      break;
  }

  // Double Stop Bit range
  if ( default_doublestopbit == 1 )         { mouse_data.persistent.doublestopbit = true; }
  else                                      { mouse_data.persistent.doublestopbit = false; }

  // Swap the left and right buttons 
  if ( default_swap_left_right == 1 )       { mouse_data.persistent.swap_left_right = true; }
  else                                      { mouse_data.persistent.swap_left_right = false; }

  // use forward and backward as ALT left and right buttons
  if ( default_use_forward_backward == 1 )  { mouse_data.persistent.use_forward_backward = true; }
  else                                      { mouse_data.persistent.use_forward_backward = false; }

  // Swap forward and backwards
  if ( default_swap_forward_backward == 1 ) { mouse_data.persistent.swap_forward_backward = true; }
  else                                      { mouse_data.persistent.swap_forward_backward = false; }
  
  // Invert X axis (Left and Right movement)
  if ( default_invert_x == 1 ) { mouse_data.persistent.invert_x = true; }
  else                         { mouse_data.persistent.invert_x = false; }
  
  // Invert Y axis (Up and Down movement)
  if ( default_invert_y == 1 ) { mouse_data.persistent.invert_y = true; }
  else                         { mouse_data.persistent.invert_y = false; }
  
  // Added 1.2.X Language
  if ( (default_language == 0) || (default_language == 1) ) { mouse_data.persistent.language = default_language; }
  else                                                      { mouse_data.persistent.language = 0; }
}

// Load persistent keyboard data from flash | Load defaults if no data in flash found
// There's a pile of if's to try to combat silly users.
void loadPersistentKBDDefaults() {
  kbd_data.persistent.firstrun = 0;

  // Keyboard Type
  if ( (default_keyboard_type == 0) || (default_keyboard_type == 1) ) { kbd_data.persistent.kbd_type = default_keyboard_type; }
  else                                                                { kbd_data.persistent.kbd_type = 1;}

  // Due to timings, mimicking a real ibmxt might not be possible but we'll try anyway, does not apply to AT/ps2 keyboards
  // 0 -> IBM XT | 1 --> XT Clone
  if ( (default_xtclone == 0) || (default_xtclone == 1) )     { kbd_data.persistent.kbd_xtclone = default_xtclone; }
  else                                                        { kbd_data.persistent.kbd_xtclone = 1; }
}

// Run on launch 
void initPersistentSet() {
  
  // If settings need to be saved
  bool saveset = false;

  // Load current settings from flash. A read from blank returns an array of bytes set to "255".
  loadPersistentSet();

  #if KB_ENABLE
  /* ----- First Run or FW Required Reload ----- */
  // ==================================================
  // IF First run or revision number higher than stored revision number, load default
  if ( mouse_data.persistent.firstrun == 255 || kbd_data.persistent.firstrun == 255 || V_REVISION > mouse_data.persistent.FW_V_REVISION  ) {

    #if DEBUG > 0
    printf("fristrun mouse: %d\n", mouse_data.persistent.firstrun );  fflush(stdout);
    printf("fristrun KBD: %d\n", kbd_data.persistent.firstrun );      fflush(stdout);
    printf("revision: %d\n", mouse_data.persistent.FW_V_REVISION);    fflush(stdout);
    #endif
    
    loadPersistentMOUSEDefaults();  // Load the default settings from default_config.h
    loadPersistentKBDDefaults();    // Load the keyboard default settings from default_config.h
    savePersistentSet();            // Save new persistent Data
    machine_reboot();               // Reboot Pico
  } 

  
  #else
  /* ----- First Run or FW Required Reload ----- */
  // ==================================================
  // IF First run or revision number higher than stored revision number, load default
  if ( mouse_data.persistent.firstrun == 255 || V_REVISION > mouse_data.persistent.FW_V_REVISION  ) {

    #if DEBUG > 0
    printf("fristrun: %d\n", mouse_data.persistent.firstrun );      fflush(stdout);
    printf("revision: %d\n", mouse_data.persistent.FW_V_REVISION);  fflush(stdout);
    #endif
    
    loadPersistentMOUSEDefaults();  // Load the default settings from default_config.h
    savePersistentSet();            // Save new persistent Data
    machine_reboot();               // Reboot Pico
  } 
  #endif
  
  /* ----- If The Firmware Version Has Changed ----- */
  // ==================================================
  // Just store the new version information
  if ( (V_MAJOR > mouse_data.persistent.FW_V_MAJOR || V_MINOR > mouse_data.persistent.FW_V_MINOR ) && saveset == false ){
    mouse_data.persistent.FW_V_MAJOR = V_MAJOR;
    mouse_data.persistent.FW_V_MINOR = V_MINOR;

    saveset = true;
  }

  /* ----- DIPSWITCHES----- */
  // ==================================================
  // Use Dip-switch data if dip-switch is closed and it doesn't match the stored data

  // If stored dip-switch state does not match current dip-switch state.
  if ( ( mouse_data.persistent.ST_DIPSW_THREEBTN != gpio_get(DIPSW_THREEBTN) ) || ( mouse_data.persistent.ST_DIPSW_WHEEL != gpio_get(DIPSW_WHEEL) ) ) {
    setDipMouseType();
    mouse_data.persistent.ST_DIPSW_THREEBTN = gpio_get(DIPSW_THREEBTN);
    mouse_data.persistent.ST_DIPSW_WHEEL = gpio_get(DIPSW_WHEEL);
    saveset = true;
    }

  // Mouse xy tracking speed Dip Switches
  if ( ( mouse_data.persistent.ST_DIPSW_75XYSPEED != gpio_get(DIPSW_75XYSPEED) ) || ( mouse_data.persistent.ST_DIPSW_50XYSPEED != gpio_get(DIPSW_50XYSPEED) ) ) {
    setDipMouseSpeed();
    mouse_data.persistent.ST_DIPSW_75XYSPEED = gpio_get(DIPSW_75XYSPEED);
    mouse_data.persistent.ST_DIPSW_50XYSPEED = gpio_get(DIPSW_50XYSPEED);
    saveset = true;
    }
  
  // Double stop bit Dip Switch
  if ( mouse_data.persistent.ST_DIPSW_7N2 != gpio_get(DIPSW_7N2) ) {
    mouse_data.persistent.doublestopbit = !gpio_get(DIPSW_7N2);
    mouse_data.persistent.ST_DIPSW_7N2 = gpio_get(DIPSW_7N2);
    saveset = true;
  } 

  // Baud Rate Dip Switch
  if ( mouse_data.persistent.ST_DIPSW_19200 != gpio_get(DIPSW_19200) ) {
    if ( !gpio_get(DIPSW_19200) )   { mouse_data.persistent.baudrate = 19200; }
    else                            { mouse_data.persistent.baudrate = 1200; }
    mouse_data.persistent.ST_DIPSW_19200 = gpio_get(DIPSW_19200);
    saveset = true;
  } 


  /* ----- Save Any Changes----- */
  // ==================================================
  if ( saveset ) { savePersistentSet(); }


  /* ----- Handy DEBUG printout----- */
  // ==================================================
  #if DEBUG > 0
    printf("Mouse Settings print out\n");

    fflush(stdout);

    printf("FW_V_MAJOR: %d | FW_V_MINOR: %d | FW_V_REVISION: %d | FW_Language: %d\n",
      mouse_data.persistent.FW_V_MAJOR,
      mouse_data.persistent.FW_V_MINOR,
      mouse_data.persistent.FW_V_REVISION,
      mouse_data.persistent.language
    );

    fflush(stdout);

    printf("xytravel_percentage: %d | xtravel_percentage: %d | ytravel_percentage: %d\n",
      mouse_data.persistent.xytravel_percentage,
      mouse_data.persistent.xtravel_percentage,
      mouse_data.persistent.ytravel_percentage
    );

    fflush(stdout);

    printf("mouse_movt_type: %d | use_cosine_smoothing: %d\n",
      mouse_data.persistent.mouse_movt_type,
      mouse_data.persistent.use_cosine_smoothing
    );

    fflush(stdout);

    printf("mousetype: %d | doublestopbit: %d | baud-rate: %d\n",
      mouse_data.persistent.mousetype,
      mouse_data.persistent.doublestopbit,
      mouse_data.persistent.baudrate
    );

    fflush(stdout);

    printf("swap_left_right: %d | use_forward_backward: %d | swap_forward_backward: %d\n",
      mouse_data.persistent.swap_left_right,
      mouse_data.persistent.use_forward_backward,
      mouse_data.persistent.swap_forward_backward
    );

    fflush(stdout);

    printf("Invert X: %d | Invert Y: %d\n",
      mouse_data.persistent.invert_x,
      mouse_data.persistent.invert_y
    );

    fflush(stdout);

    #if KB_ENABLE

    printf("======================================\n"); 
    fflush(stdout);

    printf("Keyboard Persistent Settings print out\n");
    fflush(stdout);

    printf("Keyboard Type: %s\n", (kbd_data.persistent.kbd_type ? "AT" : "XT") );
    fflush(stdout);

    printf("XT Compatibility Type: %s\n", (kbd_data.persistent.kbd_xtclone ? "XT CLone" : "ibmXT") );
    fflush(stdout);

    #endif // enable keyboard

  #endif
}


/*
* Some kind of wear leveling for the pico's flash memory
* The only time this reports 0 is for the first time run
* If this reports 16, then flash needs to be erased
*/
ushort findEmptyPage() {
  uint8_t* flash_target_contents = (uint8_t *) (XIP_BASE + FLASH_TARGET_OFFSET);

  for ( ushort i = 0 ; i <= FLASH_SECTOR_SIZE_C/FLASH_PAGE_SIZE ; i++ ) {
    // If the current page being looked at is blank, this is the first run var
    if ( flash_target_contents[ (i*FLASH_PAGE_SIZE) ] == 255 ) {
      return i;
    }
  }
}

void savePersistentSet() {

  // declare the variables we need
  uint32_t ints;
  uint8_t buffer[FLASH_PAGE_SIZE];

  // Write persistent data to buffer array
  buffer[0] = mouse_data.persistent.firstrun;
  buffer[1] = mouse_data.persistent.FW_V_MAJOR;
  buffer[2] = mouse_data.persistent.FW_V_MINOR;
  buffer[3] = mouse_data.persistent.FW_V_REVISION;

  buffer[4] = mouse_data.persistent.xytravel_percentage;
  buffer[5] = mouse_data.persistent.xtravel_percentage;
  buffer[6] = mouse_data.persistent.ytravel_percentage;
  buffer[7] = mouse_data.persistent.mousetype;
  buffer[8] = mouse_data.persistent.doublestopbit;
  buffer[9] = (uint8_t) ( mouse_data.persistent.baudrate / 1200 );
  
  buffer[10] = mouse_data.persistent.swap_left_right;
  buffer[11] = mouse_data.persistent.use_forward_backward;
  buffer[12] = mouse_data.persistent.swap_forward_backward;
  buffer[13] = mouse_data.persistent.invert_x;
  buffer[14] = mouse_data.persistent.invert_y;

  buffer[15] = mouse_data.persistent.ST_DIPSW_THREEBTN;
  buffer[16] = mouse_data.persistent.ST_DIPSW_WHEEL;
  buffer[17] = mouse_data.persistent.ST_DIPSW_75XYSPEED;
  buffer[18] = mouse_data.persistent.ST_DIPSW_50XYSPEED;
  buffer[19] = mouse_data.persistent.ST_DIPSW_7N2;
  buffer[20] = mouse_data.persistent.ST_DIPSW_19200;

  // Added version 1.1.X
  buffer[21] = mouse_data.persistent.mouse_movt_type;
  buffer[22] = mouse_data.persistent.use_cosine_smoothing;

  // Added Version 1.2.X
  buffer[23] = mouse_data.persistent.language;

  #if KB_ENABLE
  buffer[128] =  kbd_data.persistent.firstrun;
  buffer[129] =  kbd_data.persistent.kbd_type;
  buffer[130] =  kbd_data.persistent.kbd_xtclone;
  #endif // enable keyboard

  // Halt all interrupts to avoid errors
  ints = save_and_disable_interrupts();                                  
  
  ushort pagenum = findEmptyPage();

  switch ( pagenum ) {
    case FLASH_SECTOR_SIZE_C/FLASH_PAGE_SIZE:  // Blank area if it's full
      pagenum = 0;
    case 0: // Prime area for first use.
      flash_range_erase( FLASH_TARGET_OFFSET, FLASH_SECTOR_SIZE_C );

      #if DEBUG > 0
      printf("Flash erased");
      #endif

    break;
  }

  // Program Target Area
  flash_range_program(FLASH_TARGET_OFFSET + (pagenum * FLASH_PAGE_SIZE), buffer, FLASH_PAGE_SIZE );

  // Restore previously halted interrupts
  restore_interrupts(ints);

  #if DEBUG > 0
  printf("Page Written");
  #endif

  return;
}

void loadPersistentSet() {
  uint8_t* flash_target_contents = (uint8_t *) (XIP_BASE + FLASH_TARGET_OFFSET);

  ushort i = 0;
  ushort j = 0;

  for ( i ; i <= FLASH_SECTOR_SIZE_C/FLASH_PAGE_SIZE ; i++ ) {
    if ( flash_target_contents[ (i*FLASH_PAGE_SIZE) ] == 255 ) { break; };
  }

  if ( i != 0 ) { i--; i = i*256; }

  // Keyboard Store
  j = i + 128;

  mouse_data.persistent.firstrun = flash_target_contents[i];
  mouse_data.persistent.FW_V_MAJOR = flash_target_contents[++i];
  mouse_data.persistent.FW_V_MINOR = flash_target_contents[++i];
  mouse_data.persistent.FW_V_REVISION = flash_target_contents[++i];

  mouse_data.persistent.xytravel_percentage = flash_target_contents[++i];
  mouse_data.persistent.xtravel_percentage = flash_target_contents[++i];
  mouse_data.persistent.ytravel_percentage = flash_target_contents[++i];
  mouse_data.persistent.mousetype = flash_target_contents[++i];
  mouse_data.persistent.doublestopbit = flash_target_contents[++i];

  mouse_data.persistent.baudrate = (uint) ( flash_target_contents[++i] * 1200 );

  mouse_data.persistent.swap_left_right = flash_target_contents[++i];
  mouse_data.persistent.use_forward_backward = flash_target_contents[++i];
  mouse_data.persistent.swap_forward_backward = flash_target_contents[++i];
  mouse_data.persistent.invert_x = flash_target_contents[++i];
  mouse_data.persistent.invert_y = flash_target_contents[++i];

  mouse_data.persistent.ST_DIPSW_THREEBTN = flash_target_contents[++i];
  mouse_data.persistent.ST_DIPSW_WHEEL = flash_target_contents[++i];
  mouse_data.persistent.ST_DIPSW_75XYSPEED = flash_target_contents[++i];
  mouse_data.persistent.ST_DIPSW_50XYSPEED = flash_target_contents[++i];
  mouse_data.persistent.ST_DIPSW_7N2 = flash_target_contents[++i];
  mouse_data.persistent.ST_DIPSW_19200 = flash_target_contents[++i];

  // Added version 1.1.X
  mouse_data.persistent.mouse_movt_type = flash_target_contents[++i];
  mouse_data.persistent.use_cosine_smoothing = flash_target_contents[++i]; 

  // Added version 1.2.X
  mouse_data.persistent.language = flash_target_contents[++i];
  
  #if KB_ENABLE
  kbd_data.persistent.firstrun = flash_target_contents[j];
  kbd_data.persistent.kbd_type = flash_target_contents[++j];
  kbd_data.persistent.kbd_xtclone = flash_target_contents[++j];
  #endif // keyboard enable

  return;
}

void updateStoredDipswitchs() {
  mouse_data.persistent.ST_DIPSW_THREEBTN =   gpio_get(DIPSW_WHEEL);
  mouse_data.persistent.ST_DIPSW_WHEEL =      gpio_get(DIPSW_THREEBTN);
  mouse_data.persistent.ST_DIPSW_75XYSPEED =  gpio_get(DIPSW_75XYSPEED);
  mouse_data.persistent.ST_DIPSW_50XYSPEED =  gpio_get(DIPSW_50XYSPEED);
  mouse_data.persistent.ST_DIPSW_7N2 =        gpio_get(DIPSW_7N2);
  mouse_data.persistent.ST_DIPSW_19200 =      gpio_get(DIPSW_19200);
}



// ==================================================================================================== //
//                                              DEBUG Tools                                             //
// ==================================================================================================== //


// I use this as a visual Que that the pico is actually running the main loop.
void blink_led_task(void)
{
	const uint32_t interval_ms = 1000;
	static uint32_t start_ms = 0;
	static bool led_state = false;
	if(board_millis() - start_ms < interval_ms) {
		return;
	}
	start_ms += interval_ms;
	board_led_write(led_state);
	led_state = !led_state;
}

// https://stackoverflow.com/questions/111928/is-there-a-printf-converter-to-print-in-binary-format
void print_binary(unsigned int number)
{ 
  if (number >> 1) {
      print_binary(number >> 1);
  }
  printf((number & 1) ? "1" : "0");
  fflush(stdout);
}


// ==================================================================================================== //
//                                             Travel Limits                                            //
// ==================================================================================================== //


int16_t travel_limit(int16_t val, uint8_t percentage, uint16_t constainval)
{
  // Do that first to avoid unnecessary processing 
  if ( val == 0 || percentage == 0 ) {
    return 0;

  }else{

    int16_t j;

    // If there is a travel percentage 
    if ( percentage != 100 ) {

      // Do the actual math
      j = (int16_t) round( ( val * (percentage / 100.0) ) );

      // Return now if zero 
      if (j == 0) {return 0;}

    }else{
      j = val;
    }

    // Constrain 
    if ( constainval != 0 ){
      j = constraini(j, (constainval * -1), constainval);
    }

    return j;
  }
}

int16_t travel_limit_d(int16_t val, double percentage, uint16_t constainval)
{
  // Do that first to avoid unnecessary processing 
  if ( val == 0 || percentage == 0 ) {
    return 0;

  }else{

    int16_t j;

    // If there is a travel percentage 
    if ( percentage != 100 ) {

      // Do the actual math
      j = (int16_t) round( val * percentage );

      // Return now if zero 
      if (j == 0) {return 0;}

    }else{
      j = val;
    }

    // Constrain 
    if ( constainval != 0 ){
      j = constraini(j, (constainval * -1), constainval);
    }

    return j;
  }
}

int16_t travel_limit_f(int16_t val, float percentage, uint16_t constainval)
{
  // Do that first to avoid unnecessary processing 
  if ( val == 0 || percentage == 0 ) {
    return 0;

  }else{

    int16_t j;

    // If there is a travel percentage 
    if ( percentage != 100 ) {

      // Do the actual math
      j = (int16_t) round( val * percentage );

      // Return now if zero 
      if (j == 0) {return 0;}

    }else{
      j = val;
    }

    // Constrain 
    if ( constainval != 0 ){
      j = constraini(j, (constainval * -1), constainval);
    }

    return j;
  }
}

/*---------------------------------------*/
//            Mouse Processing           //
/*---------------------------------------*/

// Mouse values from TinyUSB are sent here
void set_mouseclick(uint8_t spot, bool value)
{      
  // If the value has not been updated during this cycle, accept value and toggle the FlipFlop Cycle Update Flag
  if ( !mouse_data.rmpkt.btnUpdated[spot] ) 
  { 
    // If no change in value, feck it.
    if ( mouse_data.rmpkt.btnFlipFlop[spot] != value ) 
    {
      mouse_data.rmpkt.btnFlipFlop[spot] = value;
      mouse_data.rmpkt.btnUpdated[spot] = true;
    }

  // If the FlipFlop Cycle Update Flag have been set
  } else {
    // If value is true and the FlipFlop is false, prioritize a click over a non click
    if      ( value && !mouse_data.rmpkt.btnFlipFlop[spot] ) { mouse_data.rmpkt.btnFlipFlop[spot] = value; } 

    // if value is false, flag flip-flop for toggling on the next cycle
    else if ( !value && mouse_data.rmpkt.btnFlipFlop[spot] ) { mouse_data.rmpkt.btnToggle[spot] = true; }     
  }

  return;
}

// Point the mouse report data to the correct places
// Called by TinyUSB
void process_mouse_report(hid_mouse_report_t const * report)
{ 
  /* ---------- LEft & Right Button State ---------- */

  // If Left and right buttons are swapped
  uint8_t leftbutton = mouse_data.persistent.swap_left_right ? 2 : 1;
  uint8_t rightbutton = mouse_data.persistent.swap_left_right ? 1 : 2;

  // If we're using the forward and backward buttons.
  if ( mouse_data.persistent.use_forward_backward ) { 
    // If the forward and backward buttons are swapped.
    leftbutton += mouse_data.persistent.swap_forward_backward ? 16 : 8;
    rightbutton += mouse_data.persistent.swap_forward_backward ? 8 : 16;
  }

  // Post data for left click
  set_mouseclick(0, report->buttons & leftbutton );

  // Post data for right click
  set_mouseclick(2, report->buttons & rightbutton );
  

  /* ---------- Mouse Location Tracking ---------- */

  // Dump our report values into variables.
  int8_t mousex = report->x;
  int8_t mousey = report->y;

  // Is mouse movement inverted
  if ( mouse_data.persistent.invert_x ) { mousex = -( mousex ); }
  if ( mouse_data.persistent.invert_y ) { mousey = -( mousey ); }

  // Add and Constrain mouse axis movement | prevent overflow.
  mouse_data.rmpkt.x = constraini( ( mouse_data.rmpkt.x + mousex ), -30000, 30000);
  mouse_data.rmpkt.y = constraini( ( mouse_data.rmpkt.y + mousey ), -30000, 30000);

  // Increment mouse movement ticker for AVG movement style.
  mouse_data.mouse_movt_ticker++;

  // Handle our two different mouse types.
  // I need the middle button data for wheel also, so no breaks.
  switch ( mouse_data.persistent.mousetype) {
  case WHEELBTN:
    mouse_data.rmpkt.wheel = mouse_data.rmpkt.wheel + report->wheel;
  case THREEBTN:
    set_mouseclick(1, report->buttons & MOUSE_BUTTON_MIDDLE);
  }
  return;
}

// Reset mouse state for the next cycle
void reset_cycle() {

  /* ----- Handle Buffered Button Clicks ----- */
  // ==================================================
  for( uint8_t i=0; i<=2; i++ ){

    // Reset update counter to False
    mouse_data.rmpkt.btnUpdated[i] = false;       

    // If the toggle flag has been set, toggle the value of the flip-flop
    // Note: This would happen if the user clicked and let go during the same cycle. 
    if ( mouse_data.rmpkt.btnToggle[i] ) { 
      
      mouse_data.rmpkt.btnFlipFlop[i] = !(mouse_data.rmpkt.btnFlipFlop[i]); // Invert the value of the flipflop
      mouse_data.rmpkt.btnToggle[i] = false;                                // Reset toggle flag
      mouse_data.rmpkt.btnUpdated[i] = true;                                // Flag Button State as updated
    }       
  }

  /* ----- Handle Specific mouse movement options ----- */
  // ==================================================
  switch ( mouse_data.persistent.mouse_movt_type ) 
  {
    case MO_MVT_ADDITIVE:   case MO_MVT_AVERAGE: 
      mouse_data.rmpkt.x = 0;           // Reset Buffered x-axis movement
      mouse_data.rmpkt.y = 0;           // Reset Buffered y-axis movement

    case MO_MVT_COAST:
      mouse_data.rmpkt.wheel = 0;       // Reset Buffered wheel movement
    break;
  }

  mouse_data.mouse_movt_ticker = 0;     // Reset mouse poll count

  return;
}

// Update stored mouse packet
void update_mousepacket() {
  MOUSE_PKT retpkt;

  /* ----- Dump in the current mouse button data ----- */
  // ==================================================
  retpkt.left   = mouse_data.rmpkt.btnFlipFlop[0];  
  retpkt.middle = mouse_data.rmpkt.btnFlipFlop[1];
  retpkt.right  = mouse_data.rmpkt.btnFlipFlop[2];
  retpkt.wheel  = constraini( mouse_data.rmpkt.wheel, -15, 15);
  retpkt.update = false;
  
  #if CON_ENABLE

  /* ----- Inject Thumbstick movement from Gamepad ----- */
  // ==================================================
  if ( gpd_data.gpd_con ) {

    // Inject value of prev_report thumbsticks into our new mouse packet, keeping possible inversion in mind
    // X-Axis
    if ( mouse_data.persistent.invert_x ) {
      mouse_data.rmpkt.x = constraini( ( mouse_data.rmpkt.x + (gpd_data.prev_report.pad_thumb[0] * -1) ), -30000, 30000);
    }  else {
      mouse_data.rmpkt.x = constraini( ( mouse_data.rmpkt.x + gpd_data.prev_report.pad_thumb[0] ), -30000, 30000);
    }

    // Y-Axis
    if ( mouse_data.persistent.invert_y ) {
      mouse_data.rmpkt.y = constraini( ( mouse_data.rmpkt.y + (gpd_data.prev_report.pad_thumb[1] * -1) ), -30000, 30000);
    } else {
      mouse_data.rmpkt.y = constraini( ( mouse_data.rmpkt.y + gpd_data.prev_report.pad_thumb[1] ), -30000, 30000);
    }

    // Increment mouse movement ticker for AVG movement style.
    mouse_data.mouse_movt_ticker++;
  }; // end if ( gpd_data.gpd_con )

  #endif

  /* ----- Handle Specific mouse movement options ----- */
  // ==================================================
  switch ( mouse_data.persistent.mouse_movt_type )
  {
    case MO_MVT_ADDITIVE: 
    
      retpkt.x = mouse_data.rmpkt.x;
      retpkt.y = mouse_data.rmpkt.y;

    break;
  
    case MO_MVT_COAST:

      retpkt.x = 0; 
      retpkt.y = 0; 

      if ( mouse_data.rmpkt.x != 0) // If x-axis buffer is not 0
      {
        if      ( mouse_data.rmpkt.x >= 127 )   { retpkt.x = 127; }
        else if ( mouse_data.rmpkt.x <= -127 )  { retpkt.x = -127; }
        else                                    { retpkt.x = mouse_data.rmpkt.x; }
        
        mouse_data.rmpkt.x += ( retpkt.x * -1); // Remove used x-axis movement from the x-axis buffer
      }

      if ( mouse_data.rmpkt.y != 0) // If y-axis buffer is not 0
      {
        if      ( mouse_data.rmpkt.y >= 127 )   { retpkt.y = 127; }
        else if ( mouse_data.rmpkt.y <= -127 )  { retpkt.y = -127; }
        else                                    { retpkt.y = mouse_data.rmpkt.y; }

        mouse_data.rmpkt.y += ( retpkt.y * -1); // Remove used y-axis movement from the y-axis buffer
      }

    break;

    case MO_MVT_AVERAGE:

      // Avoid a Div by zero err
      if ( mouse_data.mouse_movt_ticker == 0 ) { 
        retpkt.x = 0;
        retpkt.y = 0;
        break; 
      }

      // Divide the total mouse XY axis values by number of mouse updates
      retpkt.x = ( int16_t ) round( mouse_data.rmpkt.x / mouse_data.mouse_movt_ticker );
      retpkt.y = ( int16_t ) round( mouse_data.rmpkt.y / mouse_data.mouse_movt_ticker );
      
    break;
  }

  /* ----- Handle Travel Limit Options ----- */
  // ==================================================
  retpkt.x = travel_limit(retpkt.x, mouse_data.persistent.xtravel_percentage, 0); // Limit X
  retpkt.y = travel_limit(retpkt.y, mouse_data.persistent.ytravel_percentage, 0); // Limit Y
  retpkt.x = travel_limit(retpkt.x, mouse_data.persistent.xytravel_percentage, 127); // Limit XY
  retpkt.y = travel_limit(retpkt.y, mouse_data.persistent.xytravel_percentage, 127); // Limit XY
  
  /* ----- Co-Sine Mouse Smoothing ----- */
  // ==================================================
  // Low = 1280 | Medium = 1024 | High = 768 | Very High = 512
  
  if ( mouse_data.persistent.use_cosine_smoothing > 0){

    float radianVal;
    
    // Process X Axis
    if (retpkt.x !=0 ){

      radianVal = retpkt.x * (3.14 / ( 1536 - (256 * mouse_data.persistent.use_cosine_smoothing ) ) );
      retpkt.x = travel_limit_f(retpkt.x, cosf(radianVal), 0);

      #if DEBUG > 0
      printf("Cosine smoothed x: old: %d | new: %d | cos: %f\n", retpkt.x, travel_limit_f(retpkt.x, cosf(radianVal), 0), cosf(radianVal));
      #endif
    }

    // Process Y Axis
    if (retpkt.y !=0 ){

      radianVal = retpkt.y * (3.14 / ( 1536 - (256 * mouse_data.persistent.use_cosine_smoothing ) ) );
      retpkt.y = travel_limit_f(retpkt.y, cosf(radianVal), 0);

      #if DEBUG > 0
      printf("Cosine smoothed y: old: %d | new: %d | cos: %f\n", retpkt.y, travel_limit_f(retpkt.y, cosf(radianVal), 0), cosf(radianVal));
      #endif
    }
  }
  
  /* ----- Work Out IF There Is A Button Update ----- */
  // ==================================================

  // If an update is required from a previous cycle, flag update flag
  retpkt.update = mouse_data.rmpkt.btnUpdated[0] || mouse_data.rmpkt.btnUpdated[1] || mouse_data.rmpkt.btnUpdated[2];

  // If still not true, do a pile of if's
  // If the current button state is unpressed and previous state was pressed
  if ( !retpkt.update )
  {
    if      ( mouse_data.mpkt.left && !(retpkt.left) )              { retpkt.update = true; }
    else if ( mouse_data.mpkt.middle && !(retpkt.middle) )          { retpkt.update = true; }
    else if ( mouse_data.mpkt.right && !(retpkt.right) )            { retpkt.update = true; }
    else if ( retpkt.x != 0 || retpkt.y != 0 || retpkt.wheel != 0 ) { retpkt.update = true; }
  }

  /* ----- Wrap it up ----- */
  // ==================================================
  reset_cycle();              // Prepare for the next cycle
  mouse_data.mpkt = retpkt;   // Overwrite previous mouse packet

  return;

}


// ==================================================================================================== //
//                                          Keyboard Handling                                           //
// ==================================================================================================== //

/*---------------------------------------*/
//             Keyboard Timers           //
/*---------------------------------------*/

// ========== Idle locks alarm
// This alarm began life far more complicated but later simplified. 
// All this does is set the lock leds for the first most connected usb keyboard not only to look super rad cool but 
// to let the user know that the keyboard is connected but idle
int64_t idle_kbd_locks(alarm_id_t id, void *user_data) {

  // ===== Cancel the alarm to keep free space in the pool
  alarm_pool_cancel_alarm(alarm_pool_get_default(), id); 

  // ===== Process our user data
  int led = (int)user_data;           // Cast our void pointer to an int to get the current led state
  uint32_t newtime = 400;             // How long before we all the alarm again, in ms

  // ===== Sanity Checks
  if ( kbd_data.kbd_count < 1 ) { kbd_data.idle_lock_timer_id = 0; return 0; };  // Make sure at least one keyboard is connected
  if ( kbd_data.din_present )   { kbd_data.idle_lock_timer_id = 0; return 0; };  // Stop if there is a host computer connected

  // ===== Set our new LED state
  switch ( led ) {
    case 12:
      led = 0;
    case 0: case 6:
      kbd_data.cmd_set.led_state = AT_KB_LED_NONE;  newtime = 2000; break;
    case 1: case 11:
      kbd_data.cmd_set.led_state = AT_KB_LED_N;     break;
    case 2: case 10:
      kbd_data.cmd_set.led_state = AT_KB_LED_NC;    break;
    case 3: case 9:
      kbd_data.cmd_set.led_state = AT_KB_LED_NCS;   newtime = 800;  break;
    case 4: case 8:
      kbd_data.cmd_set.led_state = AT_KB_LED_CS;    break;
    case 5: case 7:
      kbd_data.cmd_set.led_state = AT_KB_LED_S;     break;
    case 13:
      kbd_data.cmd_set.led_state = AT_KB_LED_NCS;   
      led = 0;  newtime = 2000;   break;
  }

  // ===== reschedule the alarm
  kbd_data.idle_lock_timer_id = alarm_pool_add_alarm_at(alarm_pool_get_default(), delayed_by_ms(get_absolute_time(), newtime), idle_kbd_locks, (void*) (uintptr_t) (led + 1), true);

  return 0;
}


/*---------------------------------------*/
//             Useful functions          //
/*---------------------------------------*/

// Called by tusb report rec,  checks if the keyboard we received data from is a known and accepted keyboard.
bool is_kb_connected(uint8_t kbd_addr, uint8_t kbd_inst) {

    for(uint8_t i = 0; i < kbd_data.kbd_count; i++) {
        if ( ( kbd_data.kbd_tusb_addr[i][0] == kbd_addr) && (kbd_data.kbd_tusb_addr[i][1] == kbd_inst) ) {
            return true;
        }
    }
    return false;
}

// Set the LED lock state of the first most connected keyboard
void set_kbd_locks(uint8_t data) { 

  // If there are no keyboards connected, return
  if ( kbd_data.kbd_count < 1 ) { return; };

  switch ( data ) {
    case AT_KB_LED_S: // Scroll lock
        tuh_hid_set_report(kbd_data.kbd_tusb_addr[0][0], kbd_data.kbd_tusb_addr[0][1], 0, HID_REPORT_TYPE_OUTPUT, (void*)&TUSB_KB_LED_S, 1); 
        break;
    case AT_KB_LED_N: // Number lock
        tuh_hid_set_report(kbd_data.kbd_tusb_addr[0][0], kbd_data.kbd_tusb_addr[0][1], 0, HID_REPORT_TYPE_OUTPUT, (void*)&TUSB_KB_LED_N, 1);
        break;
    case AT_KB_LED_NS: // Number and scroll lock
        tuh_hid_set_report(kbd_data.kbd_tusb_addr[0][0], kbd_data.kbd_tusb_addr[0][1], 0, HID_REPORT_TYPE_OUTPUT, (void*)&TUSB_KB_LED_NS, 1); 
        break;
    case AT_KB_LED_C: // Caps lock
        tuh_hid_set_report(kbd_data.kbd_tusb_addr[0][0], kbd_data.kbd_tusb_addr[0][1], 0, HID_REPORT_TYPE_OUTPUT, (void*)&TUSB_KB_LED_C, 1);
        break;
    case AT_KB_LED_CS: // Caps and Scroll lock
        tuh_hid_set_report(kbd_data.kbd_tusb_addr[0][0], kbd_data.kbd_tusb_addr[0][1], 0, HID_REPORT_TYPE_OUTPUT, (void*)&TUSB_KB_LED_CS, 1);
        break;
    case AT_KB_LED_NC: // Num and Caps lock
        tuh_hid_set_report(kbd_data.kbd_tusb_addr[0][0], kbd_data.kbd_tusb_addr[0][1], 0, HID_REPORT_TYPE_OUTPUT, (void*)&TUSB_KB_LED_NC, 1);
        break;
    case AT_KB_LED_NCS: // Number, Caps and Scroll Lock
        tuh_hid_set_report(kbd_data.kbd_tusb_addr[0][0], kbd_data.kbd_tusb_addr[0][1], 0, HID_REPORT_TYPE_OUTPUT, (void*)&TUSB_KB_LED_NCS, 1);
        break;
    case AT_KB_LED_NONE: default: // No Locks
        tuh_hid_set_report(kbd_data.kbd_tusb_addr[0][0], kbd_data.kbd_tusb_addr[0][1], 0, HID_REPORT_TYPE_OUTPUT, (void*)&TUSB_KB_LED_NONE, 1);
        break;
  };
}

// Wrapper for the set_kbd_locks function to update the locks from the stored led_state value
void update_kbd_locks() { 
  set_kbd_locks(kbd_data.cmd_set.led_state);
  return;
}

void reset_kbd_defaults() {
  
  // ===== Din Values =====
  kbd_data.din_present = false;           // Din keyboard is no longer present
  kbd_data.din_initalised = false;        // Din keyboard is no longer active
  kbd_data.din_conn_fail = 0;             // Reset connection failure counter

  // ===== Command set stuff =====
  load_cmd_set_settings();
}

// Load the current session settings for the keyboard
void load_cmd_set_settings() {

  kbd_data.cmd_set.kbd_enabled = true;                  // Enable keyboard
  kbd_data.cmd_set.key_mkbktm = 0x07;                   // Default all keys to Make/Break/Typematic
  kbd_data.cmd_set.tm_key = 0x00;                       // Blank the typematic key
  kbd_data.cmd_set.tm_timestamp = get_absolute_time();  // Set typematic timestamp to now
  kbd_data.cmd_set.tm_delay = 500;                      // Set Default Typematic delay of 0.5 seconds
  kbd_data.cmd_set.tm_rate = 100;                       // Set Default Typematic rate of 10.9cps
  kbd_data.cmd_set.led_state = AT_KB_LED_NONE;          // Set LED state to none
 
  // if the set keyboard type is XT
  if ( kbd_data.persistent.kbd_type == 0 ) {
    kbd_data.cmd_set.scancode_set = 0x00;
  // else if persistent set ps2 code set is AUTO
  } else {
    kbd_data.cmd_set.scancode_set = 0x01;
  }

  return;
}


/*---------------------------------------*/
//             KBD Processing            //
/*---------------------------------------*/


// look up new key in previous keys
static inline bool key_in_report(hid_keyboard_report_t const *report, uint8_t keycode) {
  for(uint8_t i=0; i<6; i++) {
    if (report->keycode[i] == keycode)  return true;
  }

  return false;
}

// Called by TinyUSB
void process_kbd_report(uint8_t dev_addr, uint8_t instance, hid_keyboard_report_t const *report) {

  // ========== KRO Error ==========
  // When a USB keyboard has a rollover error from terrible matrix or the likes then it sends a report of all keys pressed with USBCode of 0x01
  // IF this happens we can disgard the report
  if (report->keycode[0] == 0x01 && report->keycode[1] == 0x01 && report->keycode[2] == 0x01 && report->keycode[3] == 0x01 && report->keycode[4] == 0x01 && report->keycode[5] == 0x01 ) {

    #if DEBUG > 0
    printf("USB Keyboard rollover error, ignoring latest report\n");
    fflush(stdout);
    #endif 

    return;
  };


  // ========== Typematic ==========
  // Controllers are not typematic so we can do this here
  // Whenever a new key is pressed or released, typematic is broken
  kbd_data.cmd_set.tm_key = 0x00;        // USB hid key 0x00 is all zeros in lookup tables
  

  // ========== Find Previous Report ==========
  // This will give us a var called kbd_number that we'll use for a loopup key 
  uint8_t kbd_number = 0;

  for ( kbd_number = 0 ; kbd_number < KB_MAX_KEYBOARDS ; kbd_number++) {

    // If we have a match with known connected keyboards
    if ( (kbd_data.kbd_tusb_addr[kbd_number][0] == dev_addr) && (kbd_data.kbd_tusb_addr[kbd_number][1] == instance) ) {
      break;

    //  If the report comes from an erroneous source
    } else if ( (kbd_number + 1) == KB_MAX_KEYBOARDS ) {

      #if DEBUG > 0
      printf("USB Keyboard report error, cannot find a valid previous report.\n");
      fflush(stdout);
      #endif 

      return;
    }

  };


  // ========== Modifiers ==========
  // Modifiers are all sent in as one uint so we need to do bitwise operations to figure out which modifier keys are pressed and which are not.
  for(uint8_t i = 0 ; i < 8 ; i++) {

    // If modifier key in new report does not match the modifier key in the previous report
    if ( ( (report->modifier >> i) & 1 ) != ( (kbd_data.kbd_tusb_prev_report[kbd_number].modifier >> i) & 1 ) ) {
      if  ( (report->modifier >> i) & 1 ) { keyboard_make ( (224 + i) ); }  // If a modifier key has been pressed
      else                                { keyboard_break( (224 + i) ); }  // else a modifier key has been released
    }
  }
  
  // ========== The rest of the keys ==========
  // Non modifiers are sent in an array of key-presses
  for(uint8_t i=0; i<6; i++) {
    
    // ===== Checking for a keyboard make
    // If the spot in the array has a keycode for us
    if ( report->keycode[i] ){  

      // If key not in previous report, then the current key is newly pressed
      // else key exists in previous report, then the key is being held
      if ( !key_in_report(&kbd_data.kbd_tusb_prev_report[kbd_number], report->keycode[i]) ) {
        
        // ===== Typematic Key =====
        // Only keyboards are Typematic so we can do this here, If checks if the typematic is enabled by the AT/PS2 command set or else the typematic key will be left blank
        if ( kbd_data.cmd_set.key_mkbktm & 0x01 ) { 
          kbd_data.cmd_set.tm_key = (report->keycode[i]);                                                   // Set Typematic key
          kbd_data.cmd_set.tm_timestamp = delayed_by_ms( get_absolute_time(), kbd_data.cmd_set.tm_delay);   // Set Typematic delay based on value set by AT/PS2 command set
        };

        keyboard_make( (report->keycode[i]) );
      }
    }

    // ===== Checking for a keyboard break
    // Else the spot in the array does not have a keycode for us, which could mean that we need to send a break
    if ( kbd_data.kbd_tusb_prev_report[kbd_number].keycode[i] ) {

      // If key exists in previous report and not in he current report then the key has been released
     if ( !key_in_report(report, kbd_data.kbd_tusb_prev_report[kbd_number].keycode[i]) ){
        keyboard_break( (kbd_data.kbd_tusb_prev_report[kbd_number].keycode[i]) );
      }
  
    }
  }

  // Overwrite the previous report with the newest report
  kbd_data.kbd_tusb_prev_report[kbd_number] = (hid_keyboard_report_t) *report;

  // Debug printout
  #if DEBUG > 0
  printf("Key1: %d | Key2: %d | Key3: %d |  Key4: %d | Key5: %d | Key6: %d\n", report->keycode[0], report->keycode[1], report->keycode[2], report->keycode[3], report->keycode[4], report->keycode[5]);
  fflush(stdout);
  #endif

}


// Called by TinyUSB
// Release all keyboad keys pressed by a disconnected keyboard. 
void delete_kbd_report(hid_keyboard_report_t report) {

  // ========== Typematic ==========
  // Controllers are not typematic so we can do this here
  // Whenever a new key is pressed or released, typematic is broken
  kbd_data.cmd_set.tm_key = 0x00;        // USB hid key 0x00 is all zeros in lookup tables

  for(uint8_t i = 0 ; i < 8 ; i++) {

    // ========== Modifiers ==========
    // Modifiers are all sent in as one uint so we need to do bitwise operations to figure out which modifier keys are pressed and which are not.
    if ( (report.modifier >> i) & 1 ) { keyboard_break( (224 + i) ); } 

    // ========== The rest of the keys ==========
    // Non modifiers are sent in an array of key-presses
    if ( i < 6 && report.keycode[i]  ) { keyboard_break( report.keycode[i] ); }
  }

  return;
}

/*---------------------------------------*/
//             GPD Processing            //
/*---------------------------------------*/

#if CON_ENABLE 

// Called by TinyUSB
void process_gpd_report(uint8_t dev_addr, uint8_t instance, gamepad_report_t *report) {
  
  // ========== Controller Filtering ==========
  if ( !gpd_data.gpd_con ) {

    #if DEBUG > 0
    printf("Controller Filtering error, controller not connected\n");
    fflush(stdout);
    #endif 

    return;

  } else if ( !(gpd_data.gpd_tusb_addr[0] == dev_addr && gpd_data.gpd_tusb_addr[1] == instance ) ) {

    #if DEBUG > 0
    printf("Controller Filtering error, report from non approved controller\n");
    fflush(stdout);
    #endif 

    return;
  
  };

  // ========== Buttons ==========
  // If there is no change in the buttons just return. We only care about the buttons 
  if ( report->pad_btns == gpd_data.prev_report.pad_btns ) { return; }


  // ========== Typematic ==========
  // Whenever a new key is pressed or released, typematic is broken
  kbd_data.cmd_set.tm_key = 0x00;        // USB hid key 0x00 is all zeros in lookup tables


  // ========== Buttons Part 2 ==========
  if ( (report->pad_btns & GPAD_DPAD_UP   ) != ( gpd_data.prev_report.pad_btns & GPAD_DPAD_UP   ) ) {
    if ( report->pad_btns & GPAD_DPAD_UP )    { keyboard_make(0x52); }
    else                                      { keyboard_break(0x52); };
  };

  if ( (report->pad_btns & GPAD_DPAD_DOWN ) != ( gpd_data.prev_report.pad_btns & GPAD_DPAD_DOWN ) ) {
    if ( report->pad_btns & GPAD_DPAD_DOWN)   { keyboard_make(0x51); }
    else                                      { keyboard_break(0x51); };
  };

  if ( (report->pad_btns & GPAD_DPAD_LEFT ) != ( gpd_data.prev_report.pad_btns & GPAD_DPAD_LEFT ) ) {
    if ( report->pad_btns & GPAD_DPAD_LEFT)   { keyboard_make(0x50); }
    else                                      { keyboard_break(0x50); };
  };

  if ( (report->pad_btns & GPAD_DPAD_RIGHT) != ( gpd_data.prev_report.pad_btns & GPAD_DPAD_RIGHT) ) {
    if ( report->pad_btns & GPAD_DPAD_RIGHT ) { keyboard_make(0x4F); }
    else                                      { keyboard_break(0x4F); };
  };

  if ( (report->pad_btns & GPAD_ST        ) != ( gpd_data.prev_report.pad_btns & GPAD_ST        ) ) {
    if ( report->pad_btns & GPAD_ST )         { keyboard_make(0x29); }
    else                                      { keyboard_break(0x29); };
  };

  if ( (report->pad_btns & GPAD_SEL       ) != ( gpd_data.prev_report.pad_btns & GPAD_SEL       ) ) {
    if ( report->pad_btns & GPAD_SEL)         { keyboard_make(0x28); }
    else                                      { keyboard_break(0x38); };
  };

  if ( (report->pad_btns & GPAD_L_STICK   ) != ( gpd_data.prev_report.pad_btns & GPAD_L_STICK   ) ) {
    if ( report->pad_btns & GPAD_L_STICK)     { keyboard_make(0x00); }
    else                                      { keyboard_break(0x00); };
  };

  if ( (report->pad_btns & GPAD_R_STICK   ) != ( gpd_data.prev_report.pad_btns & GPAD_R_STICK   ) ) {
    if ( report->pad_btns & GPAD_R_STICK)     { keyboard_make(0x00); }
    else                                      { keyboard_break(0x00); };
  };

  if ( (report->pad_btns & GPAD_LSHLDR    ) != ( gpd_data.prev_report.pad_btns & GPAD_LSHLDR    ) ) {
    if ( report->pad_btns & GPAD_LSHLDR )     { keyboard_make(0x00); }
    else                                      { keyboard_break(0x00); };
  };

  if ( (report->pad_btns & GPAD_RSHLDR    ) != ( gpd_data.prev_report.pad_btns & GPAD_RSHLDR    ) ) {
    if ( report->pad_btns & GPAD_RSHLDR )     { keyboard_make(0x00); }
    else                                      { keyboard_break(0x00); };
  };

  if ( (report->pad_btns & GPAD_LSHLDR_2  ) != ( gpd_data.prev_report.pad_btns & GPAD_LSHLDR_2  ) ) {
    if ( report->pad_btns & GPAD_LSHLDR_2 )   { keyboard_make(0x00); }
    else                                      { keyboard_break(0x00); };
  };

  if ( (report->pad_btns & GPAD_RSHLDR_2  ) != ( gpd_data.prev_report.pad_btns & GPAD_RSHLDR_2  ) ) {
    if ( report->pad_btns & GPAD_RSHLDR_2 )   { keyboard_make(0x00); }
    else                                      { keyboard_break(0x00); };
  };

  if ( (report->pad_btns & GPAD_BTN_1     ) != ( gpd_data.prev_report.pad_btns & GPAD_BTN_1     ) ) {
    if ( report->pad_btns & GPAD_BTN_1 )      { keyboard_make(0xE0); }
    else                                      { keyboard_break(0xE0); };
  };

  if ( (report->pad_btns & GPAD_BTN_2     ) != ( gpd_data.prev_report.pad_btns & GPAD_BTN_2     ) ) {
    if ( report->pad_btns & GPAD_BTN_2 )      { keyboard_make(0x2C); }
    else                                      { keyboard_break(0x2C); };
  };

  if ( (report->pad_btns & GPAD_BTN_3     ) != ( gpd_data.prev_report.pad_btns & GPAD_BTN_3     ) ) {
    if ( report->pad_btns & GPAD_BTN_3 )      { keyboard_make(0xE2); }
    else                                      { keyboard_break(0xE2); };
  };

  if ( (report->pad_btns & GPAD_BTN_4     ) != ( gpd_data.prev_report.pad_btns & GPAD_BTN_4     ) ) {
    if ( report->pad_btns & GPAD_BTN_4 )      { keyboard_make(0xE1); }
    else                                      { keyboard_break(0xE1); };
  };

  return;

}

#endif 

// ==================================================================================================== //
//                                            DIN port IRQ                                              //
// ==================================================================================================== //


void dinPresentingCallback(uint gpio, uint32_t events) {

  #if DEBUG > 0 
    printf("Din Presenting Callback called\n"); 
    fflush(stdout);
  #endif

  // Host pc does nothing for the first three seconds.
  //kbd_data.din_polling_target =  delayed_by_us( get_absolute_time(), 3000000);

  gpio_acknowledge_irq(gpio, events);         // ACK GPIO IRQ
  gpio_set_irq_enabled(gpio, events, 0);      // Disable the IRQ since we don't need it anymore
  kbd_data.din_present=true;                  // Flag possible physical connection to computer


  load_cmd_set_settings();                    // Load the live keyboard settings, mostly the command set settings.

  if ( kbd_data.persistent.kbd_type == 0 && kbd_data.persistent.kbd_xtclone == 0 ){             // Pull down the data line to try to mimick ibm xt keyboards
    gpio_put( PS2_DATA_OUT, 1);
  }

  return;
}
