LimeProgramming/USB-2-232-KBD/fimware/include/utils.h

#include "tusb.h"
#include "pico.h"
#include "ctypes.h"

#ifndef UTILS_H_ 
#define UTILS_H_

/*---------------------------------------*/
//               Utilities               //
/*---------------------------------------*/

int constraini(int16_t value, int16_t min, int16_t max);

void init_pinheader(uint pin);

void init_led(uint pin);

void machine_reboot();

void blink_aled(uint gpio, uint8_t code);

/*---------------------------------------*/
//            Repeating Timers           //
/*---------------------------------------*/

void startTerminalTimer();

void stopTerminalTimer();

void startPWRBlinkerTimer();

void stopPWRBlinkerTimer();

/*---------------------------------------*/
//          Mouse Settings Stuff         //
/*---------------------------------------*/

void calcSerialDelay();

void setDipSerialBaud();

void setDipMouseType();

void setDipMouseSpeed();

/*---------------------------------------*/
//             Dip Switch IRQ            //
/*---------------------------------------*/

void dipswGPIOCallback(uint gpio, uint32_t events);


/*---------------------------------------*/
//              DIN port IRQ             //
/*---------------------------------------*/

void dinPresentingCallback(uint gpio, uint32_t events);


/*---------------------------------------*/
//           Persistent Settings         //
/*---------------------------------------*/

void initPersistentSet();

void savePersistentSet();

void loadPersistentSet();

void loadPersistentMOUSEDefaults();

void loadPersistentKBDDefaults();

void loadPersistentDefaults();

void updateStoredDipswitchs();

/*---------------------------------------*/
//              DEBUG Tools              //
/*---------------------------------------*/

void blink_led_task(void);

void print_binary(unsigned int number);


/*---------------------------------------*/
//             Travel Limits             //
/*---------------------------------------*/

int16_t travel_limit(int16_t val, uint8_t percentage, uint16_t constainval);

int16_t travel_limit_d(int16_t val, double percentage, uint16_t constainval);

int16_t travel_limit_f(int16_t val, float percentage, uint16_t constainval);


/*---------------------------------------*/
//            Mouse Processing           //
/*---------------------------------------*/

void set_mouseclick(uint8_t spot, bool value);

void process_mouse_report(hid_mouse_report_t const * report);

void reset_cycle();

void update_mousepacket();


/*---------------------------------------*/
//             Keyboard Timers           //
/*---------------------------------------*/

int64_t idle_kbd_locks(alarm_id_t id, void *user_data);

bool is_idle_kbd_locks(alarm_pool_t *pool);


/*---------------------------------------*/
//           Useful KBD functions        //
/*---------------------------------------*/

bool is_kb_connected(uint8_t kbd_addr, uint8_t kbd_inst);

void set_kbd_locks(uint8_t data);

void update_kbd_locks();

void reset_kbd_defaults();

void load_cmd_set_settings();


/*---------------------------------------*/
//             KBD Processing            //
/*---------------------------------------*/

void process_kbd_report(uint8_t dev_addr, uint8_t instance, hid_keyboard_report_t const *report);

void delete_kbd_report(hid_keyboard_report_t report);


/*---------------------------------------*/
//             GPD Processing            //
/*---------------------------------------*/
void process_gpd_report(uint8_t dev_addr, uint8_t instance, hid_gamepad_report_t *report);


#endif
