LimeProgramming/USB-2-232-KBD/(commit log)

2022-11-07 Add gerber files
    [USB-2-232-AT-BOM.xls, USB-2-232-KBD.kicad_pcb, USB-2-232-KBD.kicad_sch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]
2022-11-19 fixing up the idle locks
    [hid_app.c, ps2dev.c, usb-2-232-kbd.c, utils.c, utils.h]
2022-11-19 idle lock leds works a little better now
2022-11-20 Hardware update
    Added a Bleed resistor. My AT machine has a bleed resistor of 150R, so I added a bleed resistor of 120K to the PCB. It shouldn't interfere with the keyboard controller nor add much to power draw but it will eventually drain the capacitors and that's all that really matters
    [USB-2-232-AT-BOM.xls, USB-2-232-KBD-BOM.xls, USB-2-232-KBD.kicad_pcb, USB-2-232-KBD.kicad_sch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]
2022-11-20 fixed JLCPCB gerber
    [USB-2-232-KBD-CPL.csv]
2022-11-26 Create Drivers
2022-11-26 Custom Mouse Drivers
    CT mouse v2.0A
2022-11-26 Custom mouse drivers
    CT mouse V2.1b
2022-11-26 Modified Mouse Drivers
    Cutemouse version 1.9.1
2022-12-03 Scrap of planned feature
    Originally I planned to allow the user to set bios overwrites for the keyboard locks, I couldn't implement it in a way I liked that that also didn't look really weird to an end user. So better to scrap it entirely.
    [ctypes.h, default_config.h, ps2dev.c, ps2dev.h, usb-2-232-kbd.c, utils.c]
2022-12-11 bug fix
    it now lets go of buttons properly
    [ps2dev.c, utils.c]
2022-12-19 Create Led Animation.gif
2023-01-08 updte
    missed this file
    [utils.c]
2024-07-09 update
    seems like the update to tinyusb is promising. now if I still had my old microsoft keyboard with tons of consumer keyboard buttons, it might be fun
